JohnPD99/PA_stage_Cubesat/Theory PA Thesis/Preliminary Prototype (fail)/2020_0123_045143_145.JPG

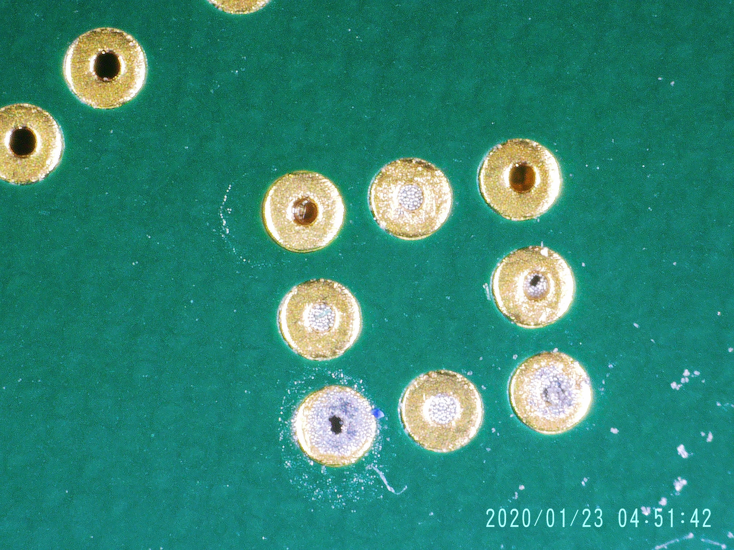
Theory PA Thesis/Preliminary Prototype (fail)/2020_0123_045143_145.JPG
