JohnPD99/PA_stage_Cubesat/Theory PA Thesis/Devboard_TQP9111_Qorvo/TQP9111 PCB2600.jpg

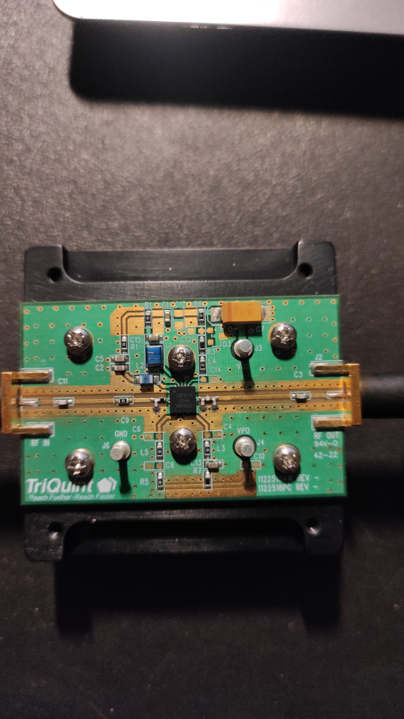
Theory PA Thesis/Devboard_TQP9111_Qorvo/TQP9111 PCB2600.jpg
