JohnPD99/PA_stage_Cubesat/Theory PA Thesis/Update Presentations/Update_W1.pdf

# Design of a PA for a linear transponder on a CubeSat

## Semester thesis

## Linear transponder

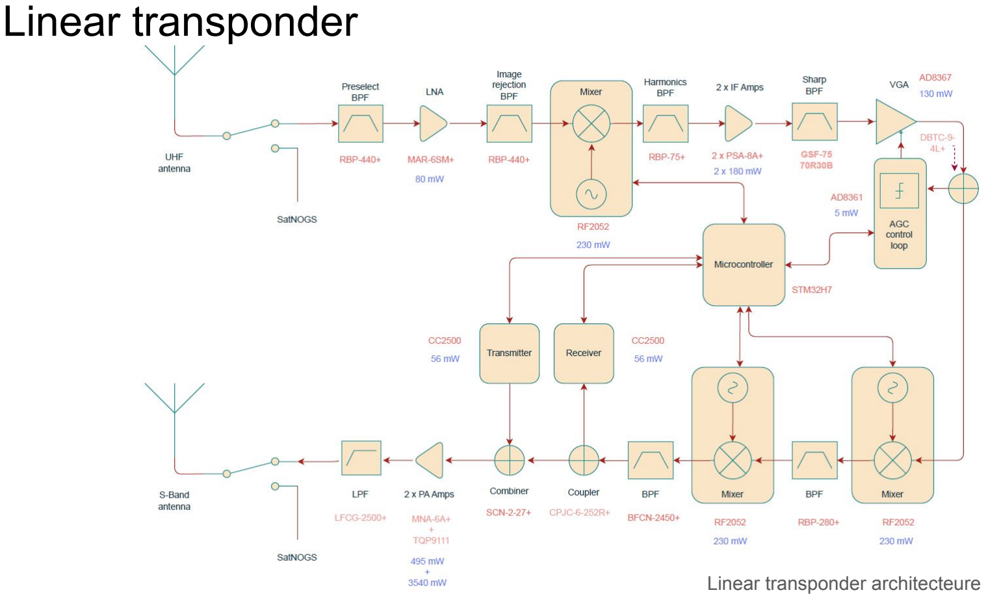
[picture p3: page 2]

Linear transponder architecteure

## Prototype PCB

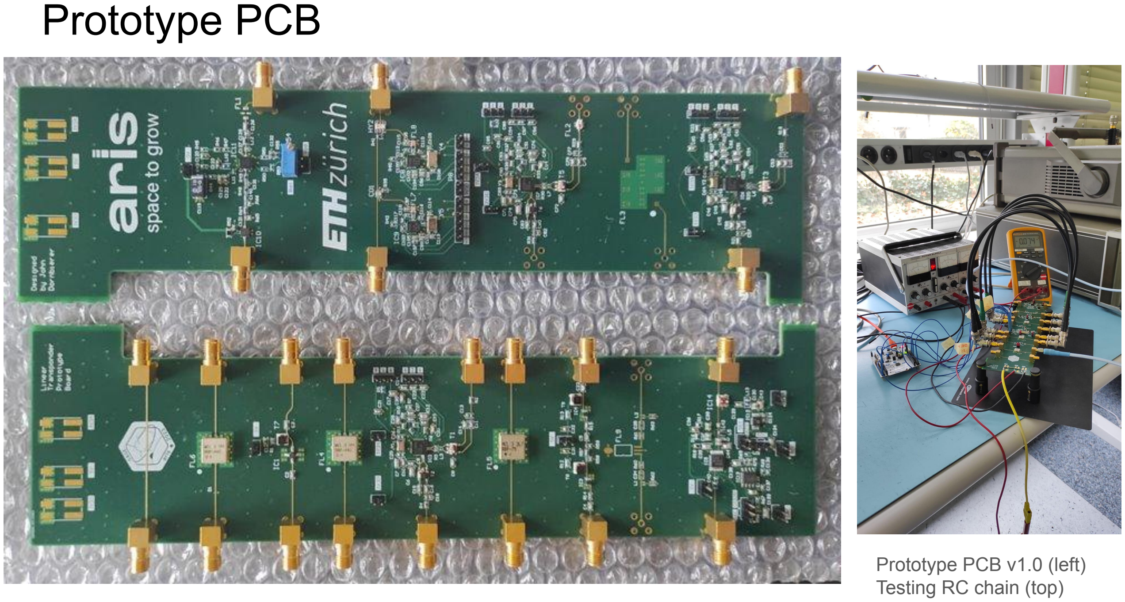
[picture p4: page 3]

Prototype PCB v1.0 (left)
Testing RC chain (top)

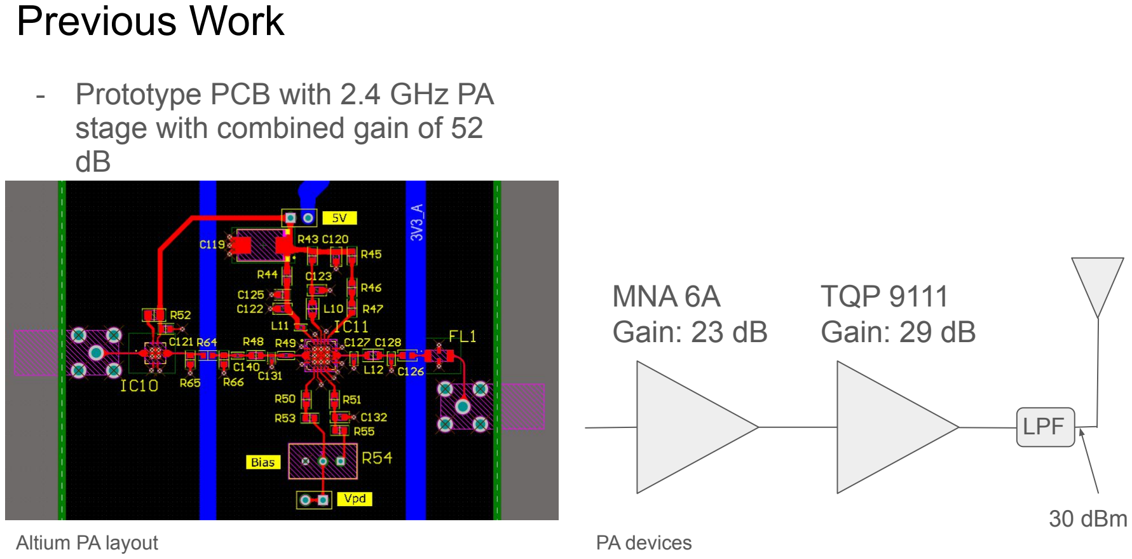
[picture p5: figure]
Previous Work; - Prototype PCB with 2.4 GHz PA stage with combined gain of 52 dB; MNA 6A Gain: 23 dB; TQP 9111 Gain: 29 dB; LPF; 30 dBm; Altium PA layout; PA devices

## Measurements

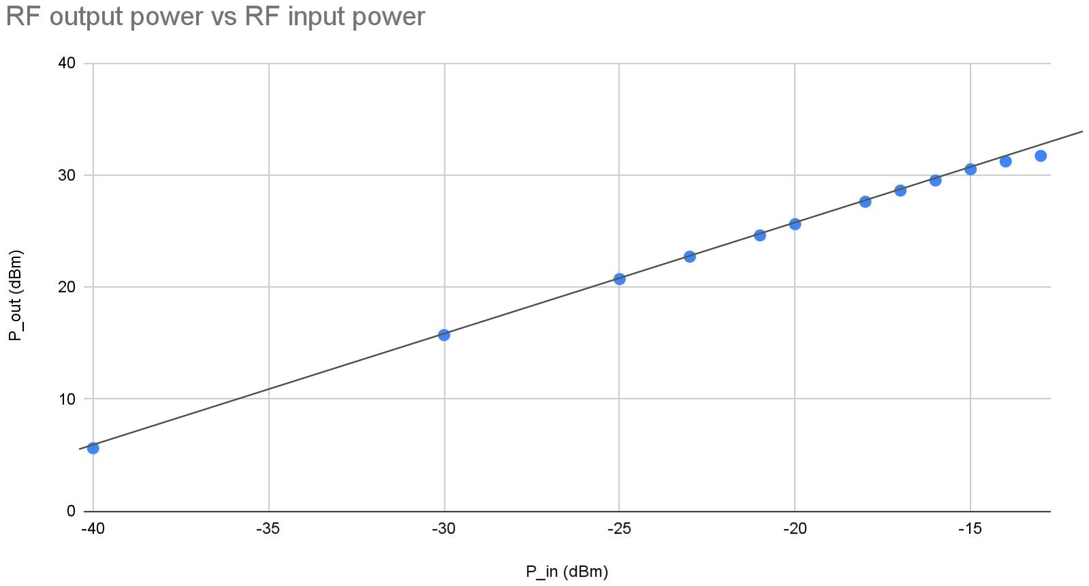
[picture p6: figure]

P1dB:

Measured: 31.7 dBm

datasheet: 32.8 dBm

Gain:

Measured: 45.7 dB

Expected: 52 dB

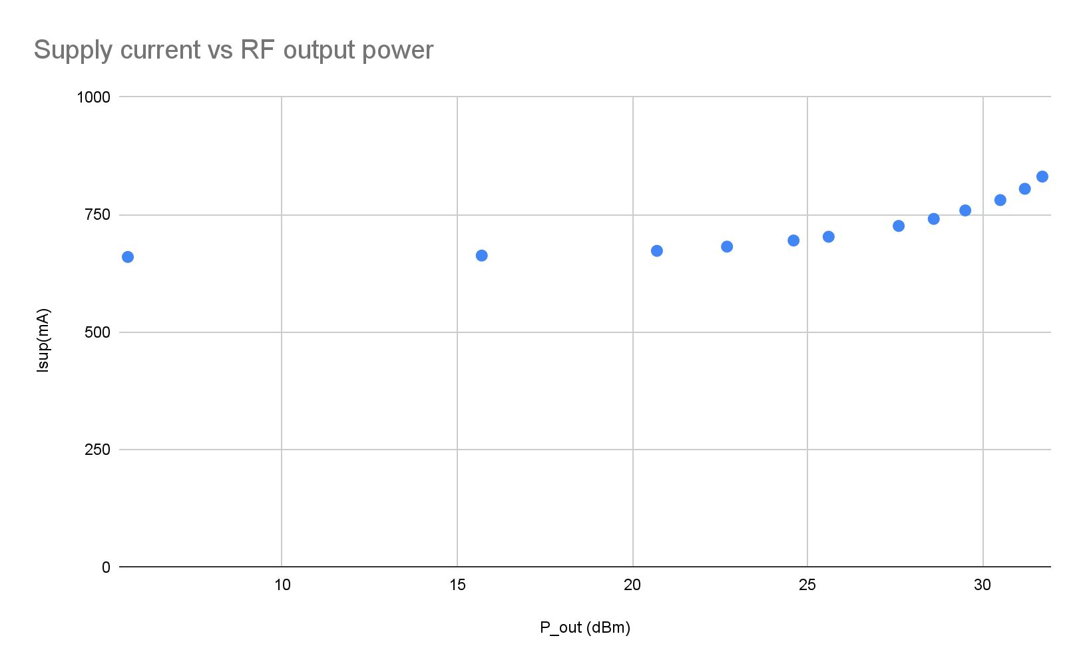
[picture p7: figure]

P_out:

30.5 dBm

Isup:

781 mA (including preamp)

~ 681 mA (without preamp)

Power consumption

~3.4 W

Power dissipation

~2.28 W

## Issues

- Overheating: Prototype wasn’t designed with a heatsink
- TQP9111 reached 150°C at at DC operation
- With small heat sink taped onto vias: 87°C
- → Design an adequate cooling system

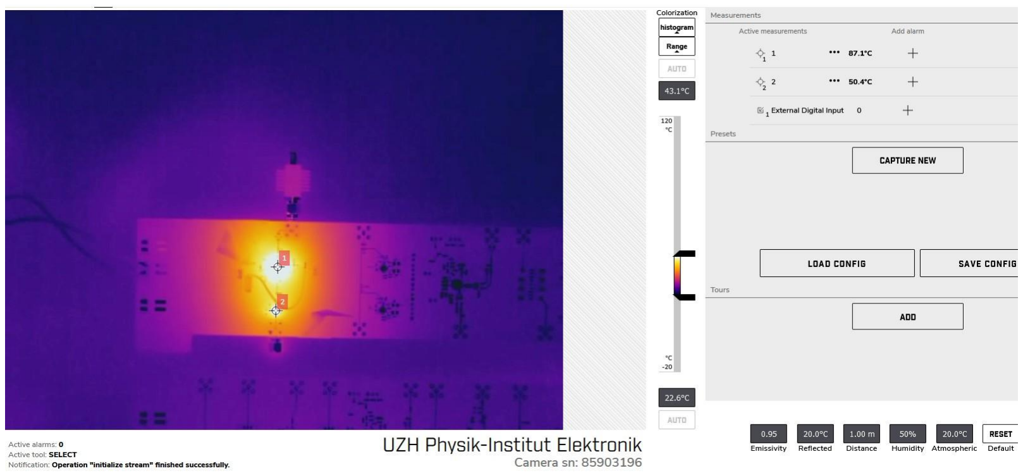
[picture p8: figure]

Thermal image (not in
vacuum, capture after 1 min of DC operation)

Bad impedance matching:

- TL lengths must be adapted (Manufacturer Dev board uses NELCO substrate, we use FR4) → 6.3 dB gain difference compared to expected gain
- → simulate adapted matching in Qucs

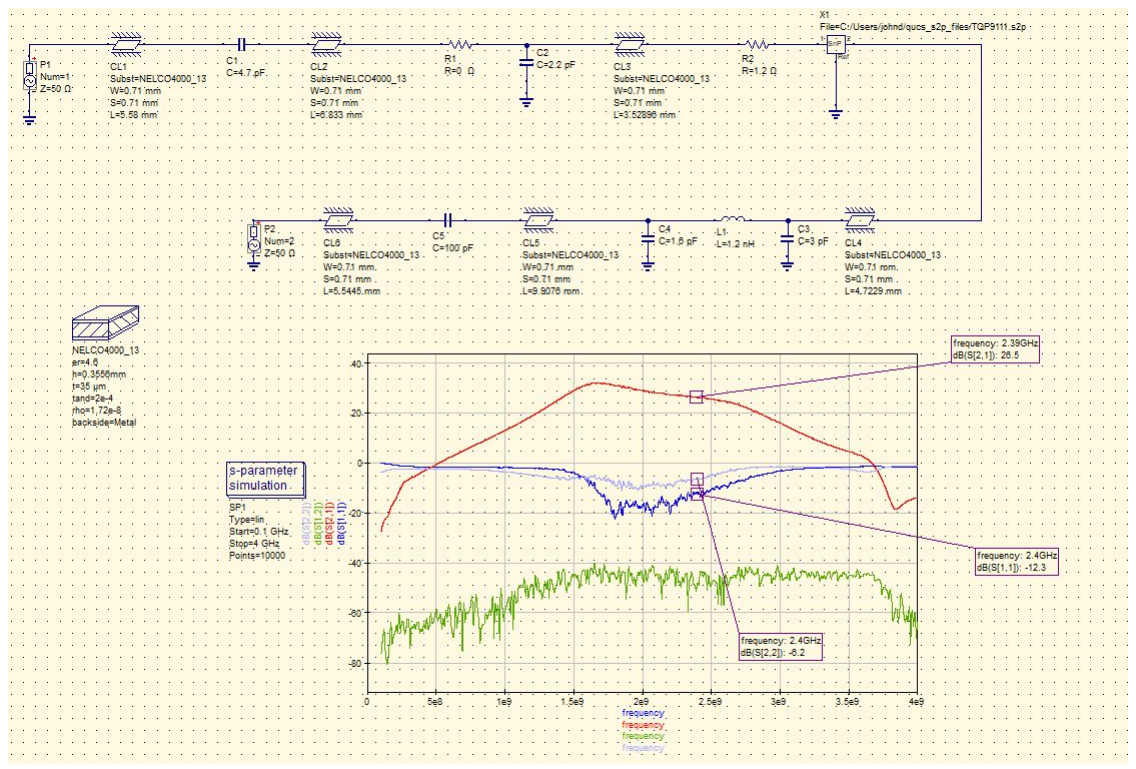
[picture p9: figure]

Qucs simulation of adapted TL lengths for FR4 substrate

## Plan

- Failure Analysis → already done
- Redefine system requirements for PA, since there are no clear defined requirements and check if correct PA choice was made

Gain: 52 dB

P_out: 30 dBm

ACLR, Linearity requirements?

- Redesign a prototype PA PCB
- Implement on Cubesat PCB

## Cubesat PCB

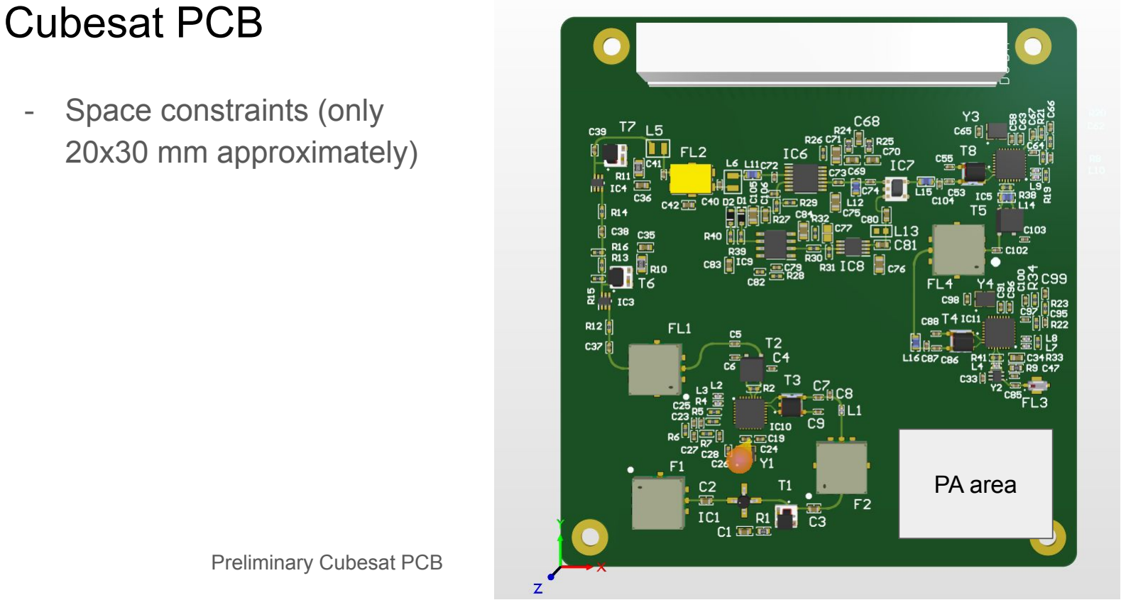
[picture p10: page 10]

- Space constraints (only
20x30 mm approximately)

PA area

Preliminary Cubesat PCB
