JohnPD99/PA_stage_Cubesat/Theory PA Thesis/Update Presentations/Update_W3.pdf

# Amplifier for Linear Transponder: Update W3

## John Dornbierer Semester Thesis

# Reminder

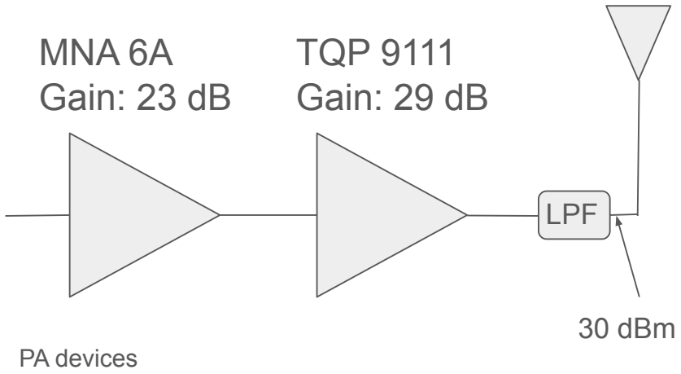
[picture p11: figure]
MNA 6A Gain: 23 dB; TQP 9111 Gain: 29 dB; LPF; 30 dBm; PA devices

## Updates

- Ordered Devboard of TQP9111 (main amplifier). It uses an expensive RF substrate (NELCO 4000). Idea: Use it as a reference to measure performance degradation on FR4 7628 substrate (used for linear transponder in Cubesat)

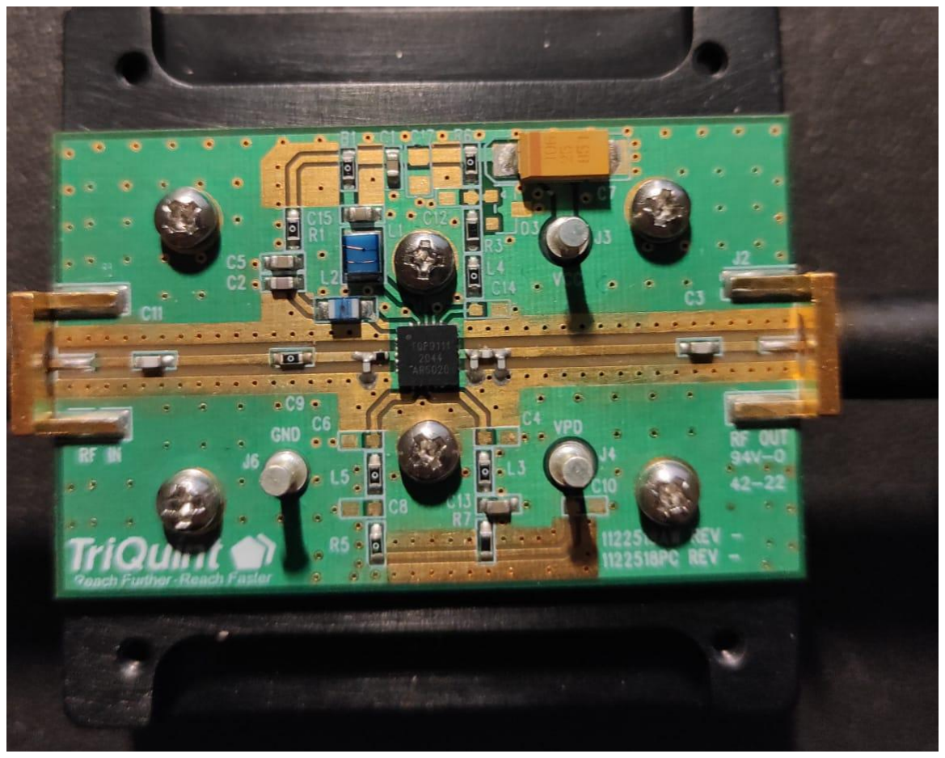
[picture p12: figure]

Qorvo PCB2600 Dev Board

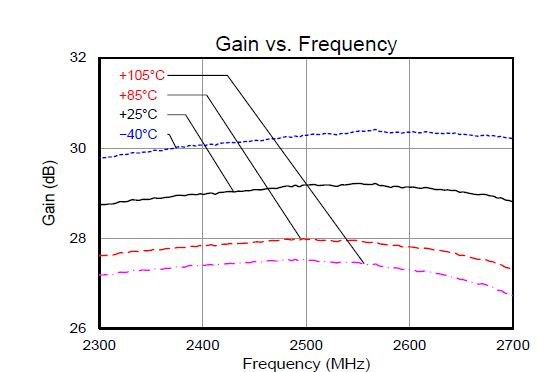
[picture p13: figure]

Qorvo PCB2600 Datasheet advertised gain

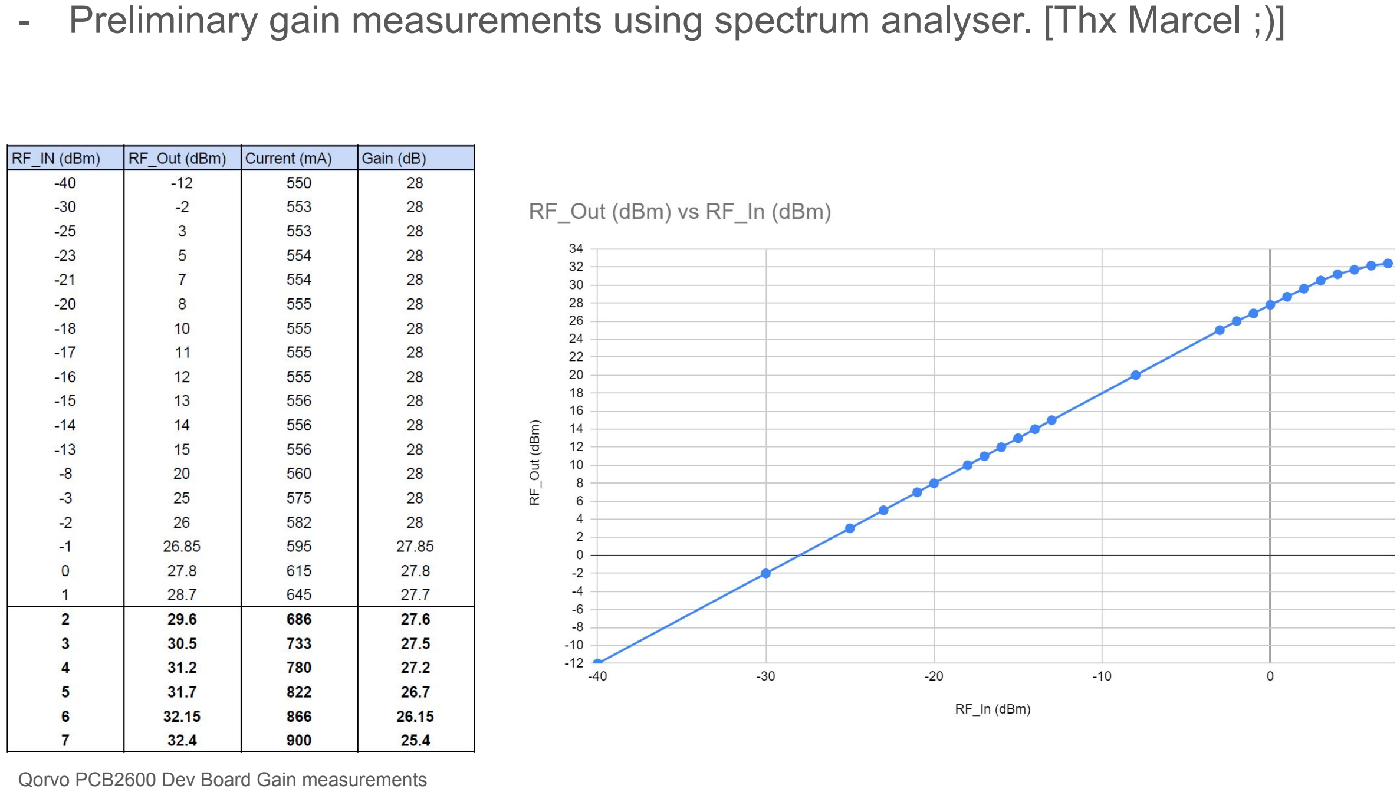
[picture p14: page 4]

- Preliminary gain measurements using spectrum analyser. [Thx Marcel ;)]

Qorvo PCB2600 Dev Board Gain measurements

Results compared to datasheet:

- Gain at low RF input power:

DevBoard: 28 dB (VCC 5V 550 mA, ~25 °C)

Datasheet: 29 dB (VCC 5V 545 mA, 25°C)

- Gain at 30.5 dBm RF output power

DevBoard: 27.5 dB (VCC 5V 733 mA, ~25°C)

- OP1dB

DevBoard: ~31.2 dBm at ~25 °C

Datasheet: 33 dBm at 25 °C

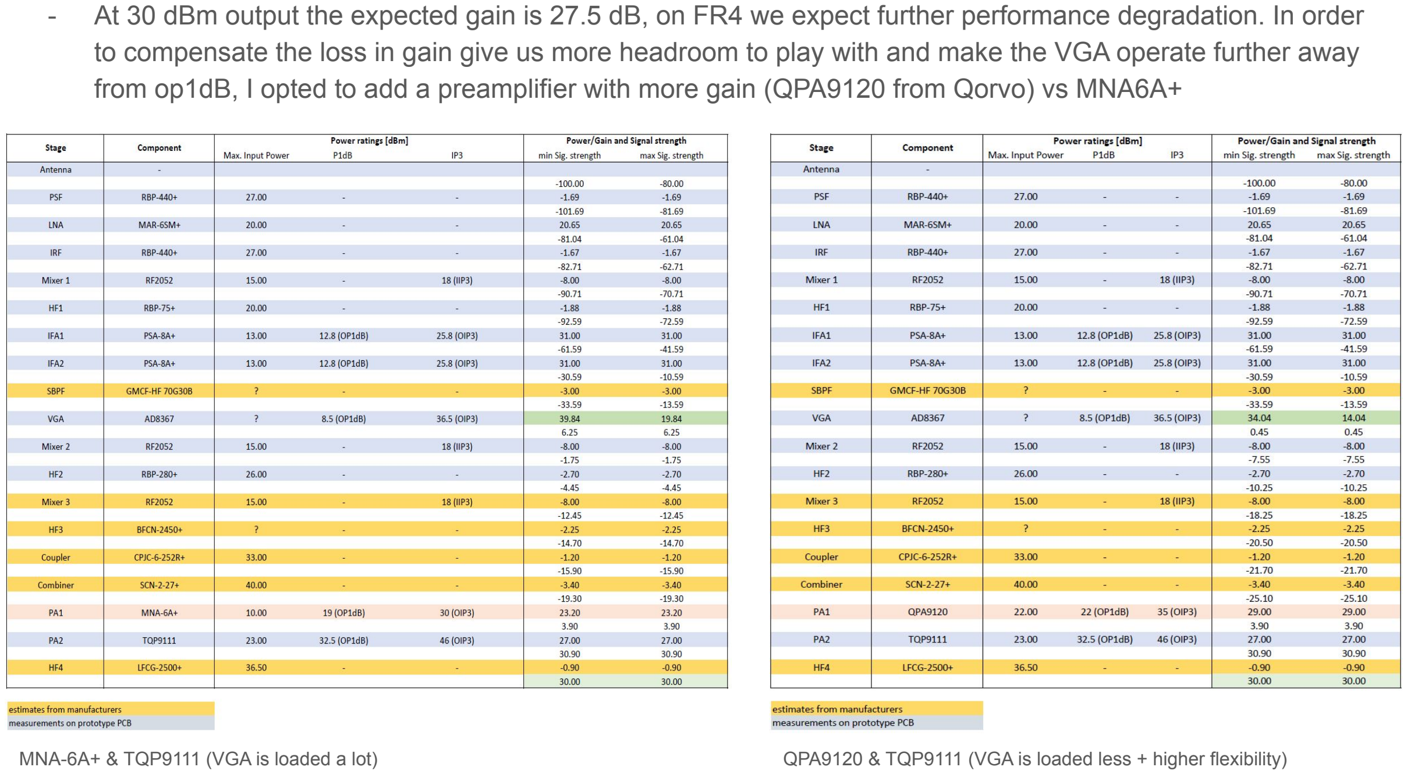
[picture p15: page 6]

- At 30 dBm output the expected gain is 27.5 dB, on FR4 we expect further performance degradation. In order to compensate the loss in gain give us more headroom to play with and make the VGA operate further away from op1dB, I opted to add a preamplifier with more gain (QPA9120 from Qorvo) vs MNA6A+
MNA-6A+ & TQP9111 (VGA is loaded a lot) | QPA9120 & TQP9111 (VGA is loaded less + higher flexibility)

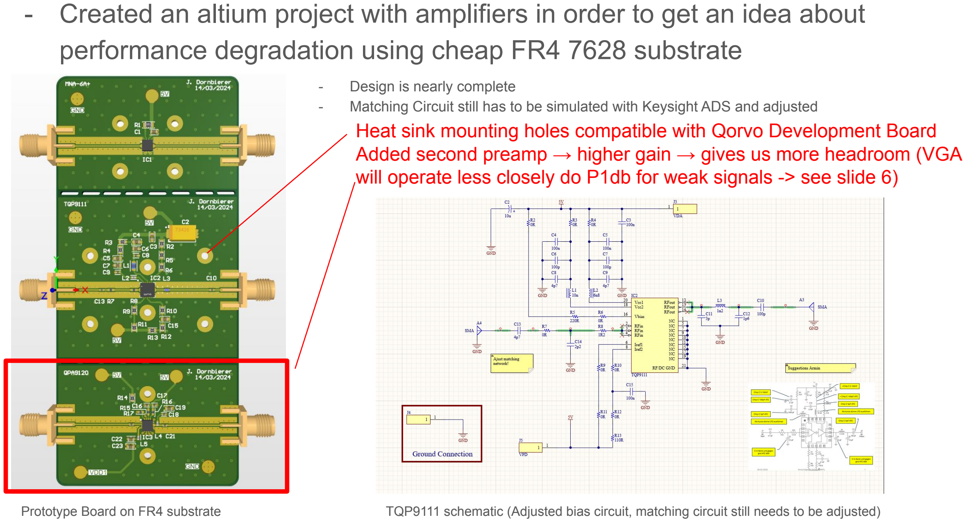
[picture p16: page 7]

- Created an altium project with amplifiers in order to get an idea about performance degradation using cheap FR4 7628 substrate
- Design is nearly complete
- Matching Circuit still has to be simulated with Keysight ADS and adjusted
Prototype Board on FR4 substrate | TQP9111 schematic (Adjusted bias circuit, matching circuit still needs to be adjusted)

Heat sink mounting holes compatible with Qorvo Development Board Added second preamp → higher gain → gives us more headroom (VGA will operate less closely do P1db for weak signals -> see slide 6)

## Impedance matching circuit

In order to gain more insights into the matching I tried to calculate the optimum source and load impedances for the TQP9111. I used de-embedded S-parameters for this.

2.4 GHz, 5V, 545 mA at 25°C

S11 = 0.802654 / 162.7281°

S21 = 9.90529 / 79.60395 °

S12 = 0.0019171 / 96.81241 °

S22 = 0.818418 / -178.5883 °

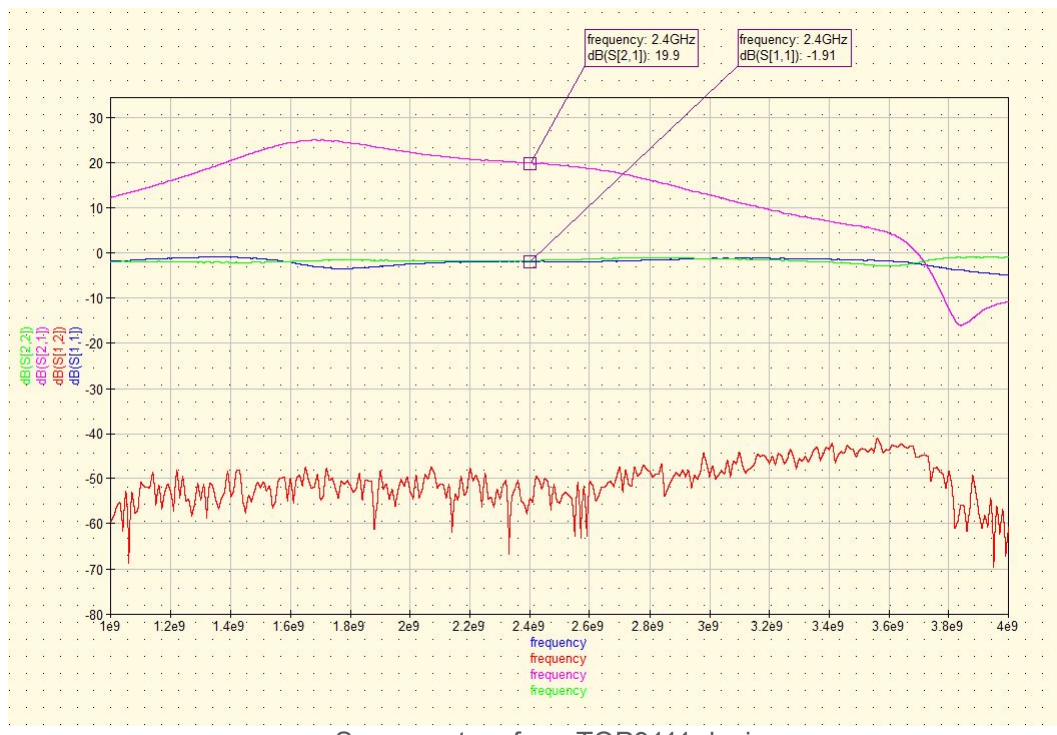
[picture p17: figure]

S-parameters from TQP9111 device

Stability:

Ds = S11 * S22 - S12 * S21 = 0.675474 / -15.5177°

K = (1 + |Ds|² - |S11|² - |S22|²) / (2*|S12|*|S21|) = 3.74425 > 1

→ unconditionally stable

Maximum achievable gain:

B1 = 1 + |S11|² - |Ds|² - |S22|² = 0.51818 > 0

MAG = 10 log(|S21| / |S12|) + 10 log(K - √K² - 1 ) = 28,4678 dB

→ According to datasheet 29 dB is possible

Optimal load impedance calculation:

C2 = S22 - Ds*conj(S11) = 0.276275 / -179.26 °

B2 = 1 + |S22|² - |Ds|² - |S11|² = 0.56929 > 0

|ΓL | = (B2 - √B2² - 4*|C2|² ) / 2*|C2| = 0.782286, ang(ΓL) = 179.26 °

→ ZL = 50 * (1+ ΓL) / (1- ΓL) = 6.10798 + 0.317883*j

Optimal source impedance calculation:

ΓS = S11 + (S12 * S21 * ΓL) / (1 + S22 * ΓL)

→ ZS = 50 * (1+ Γs) / (1- Γs) = 6.89762 - 7.78518*j

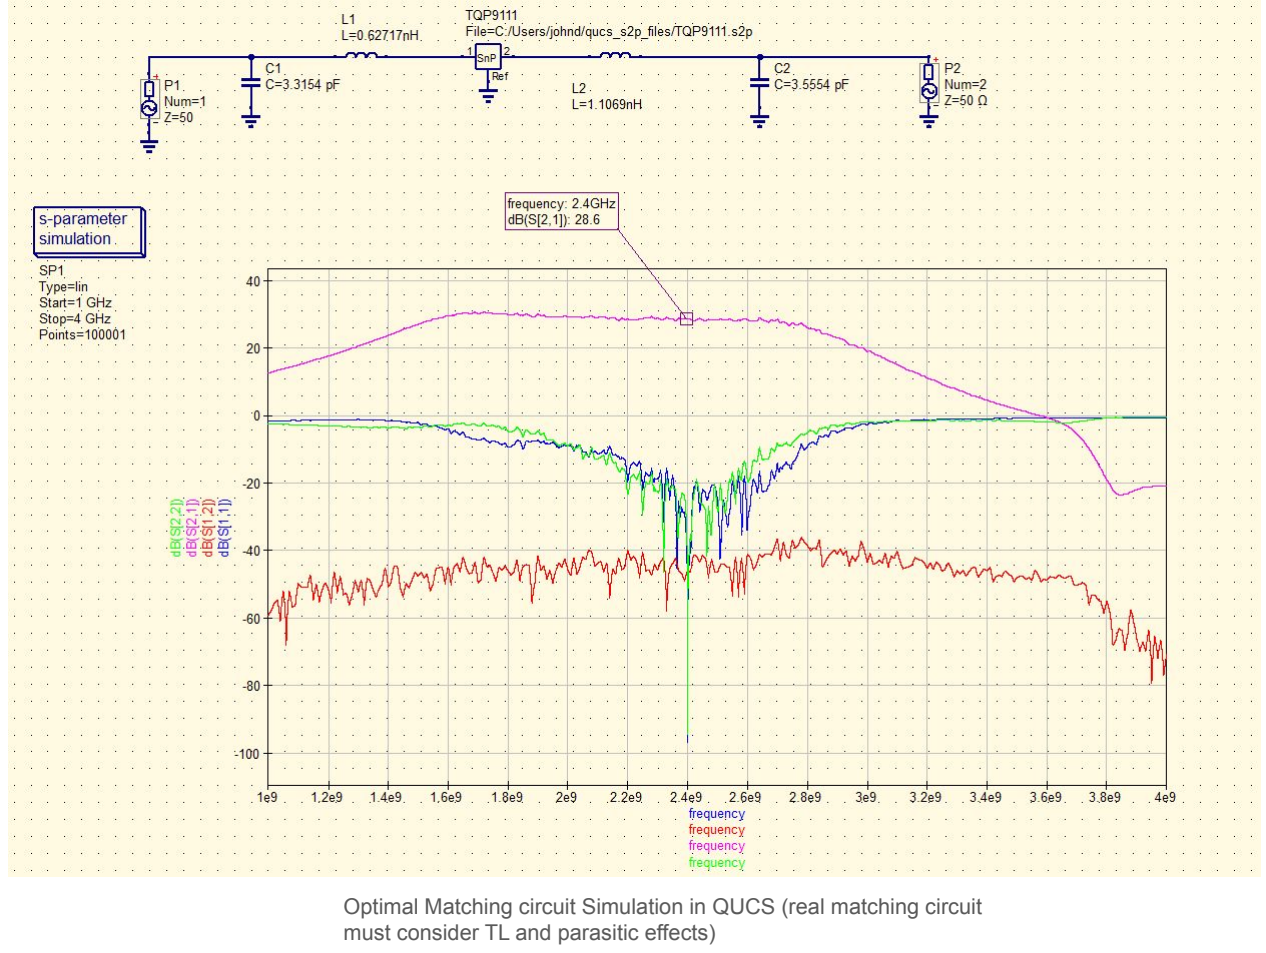
[picture p18: page 11]

Optimal Matching circuit Simulation in QUCS (real matching circuit must consider TL and parasitic effects)

## Reverse Engineering of Matching Circuit in datasheet

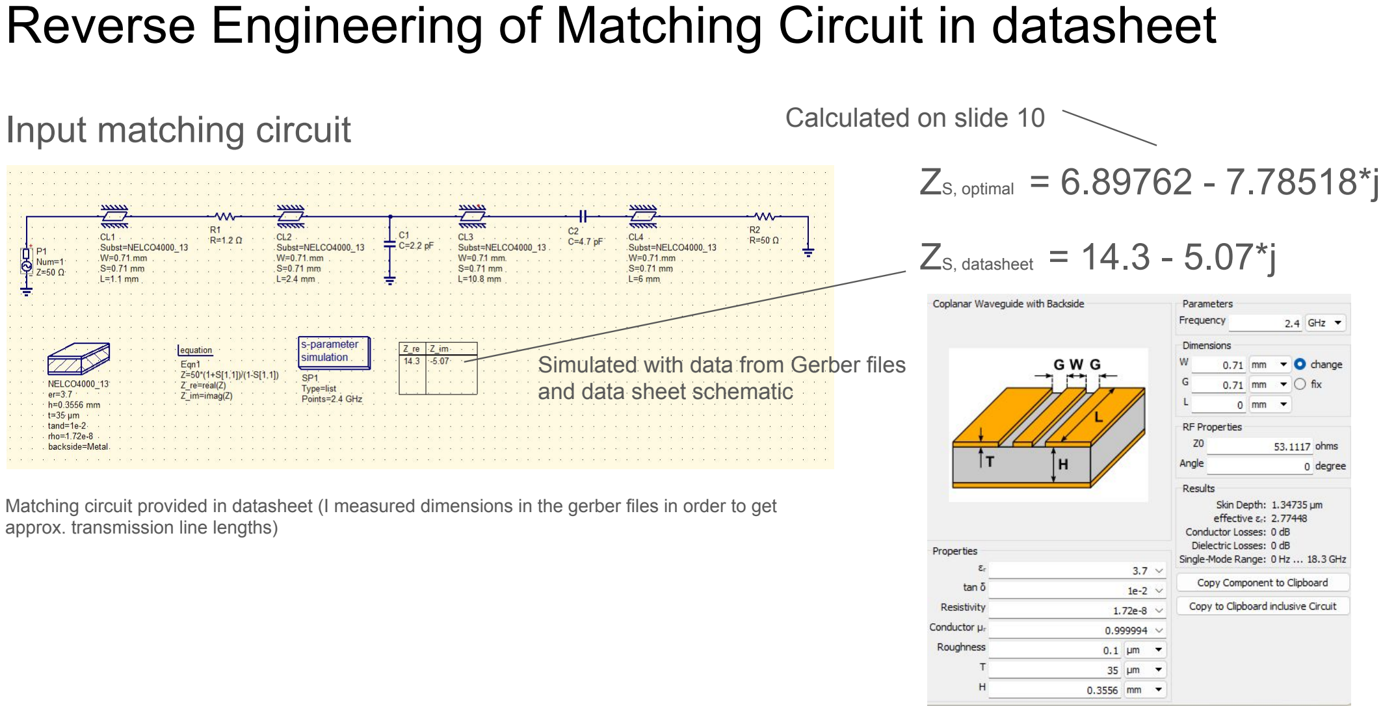
[picture p19: page 12]

Input matching circuit

Matching circuit provided in datasheet (I measured dimensions in the gerber files in order to get approx. transmission line lengths)

ZS, optimal = 6.89762 - 7.78518*j

ZS, datasheet = 14.3 - 5.07*j

Calculated on slide 10

Simulated with data from Gerber files and data sheet schematic

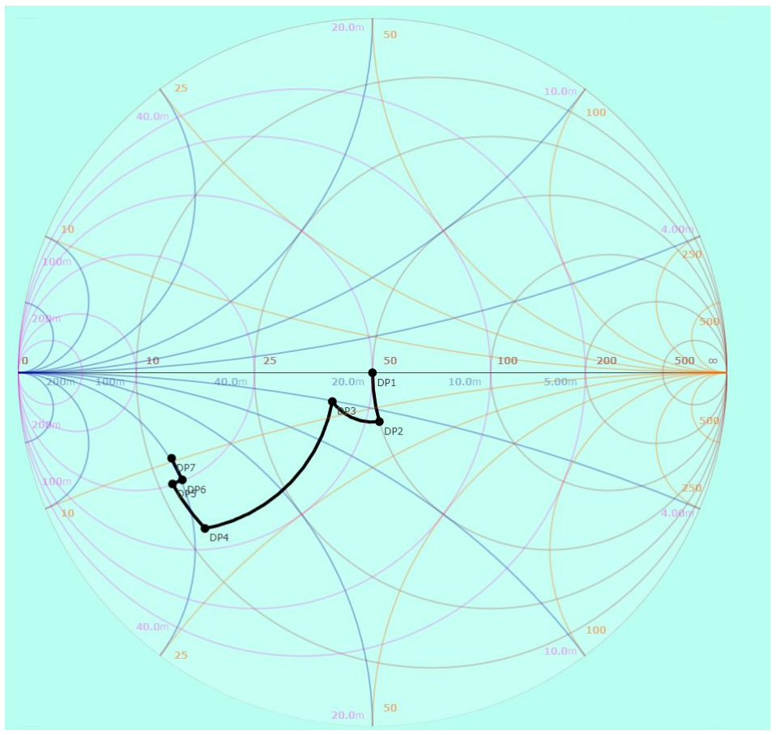
[picture p20: figure]

Smith Chart

Output matching circuit

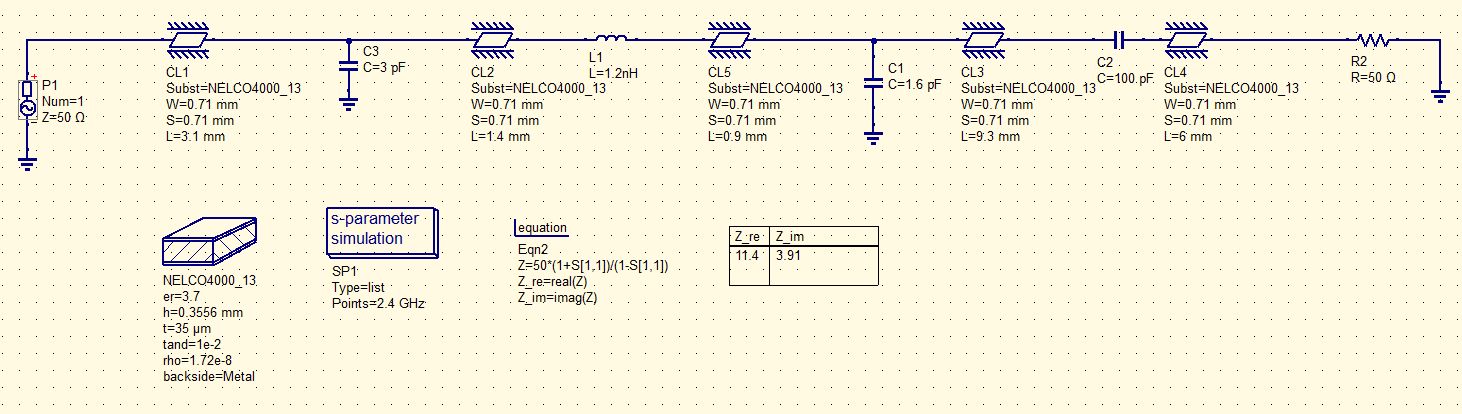
[picture p21: figure]

Matching circuit provided in datasheet (I measured dimensions in the gerber files in order to get approx. transmission line lengths)
ZL, opt = 6.10798 + 0.317883*j

ZL, datasheet = 11.4 + 3.91*j

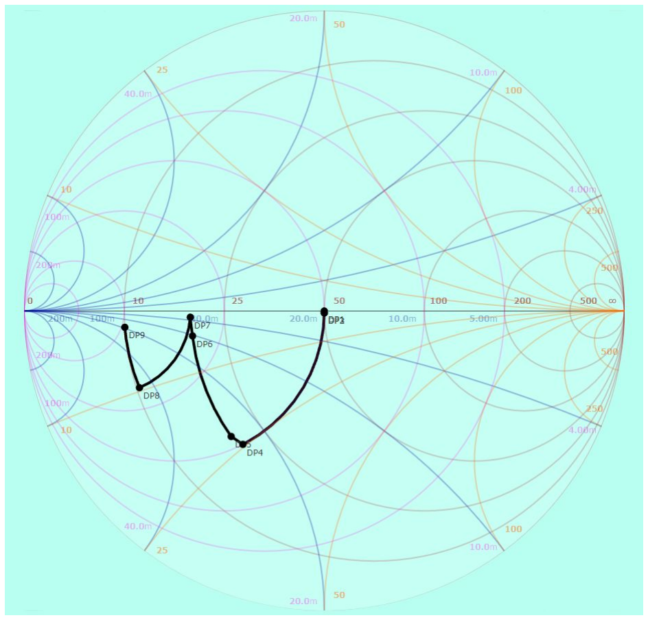
[picture p22: figure]

Smith Chart

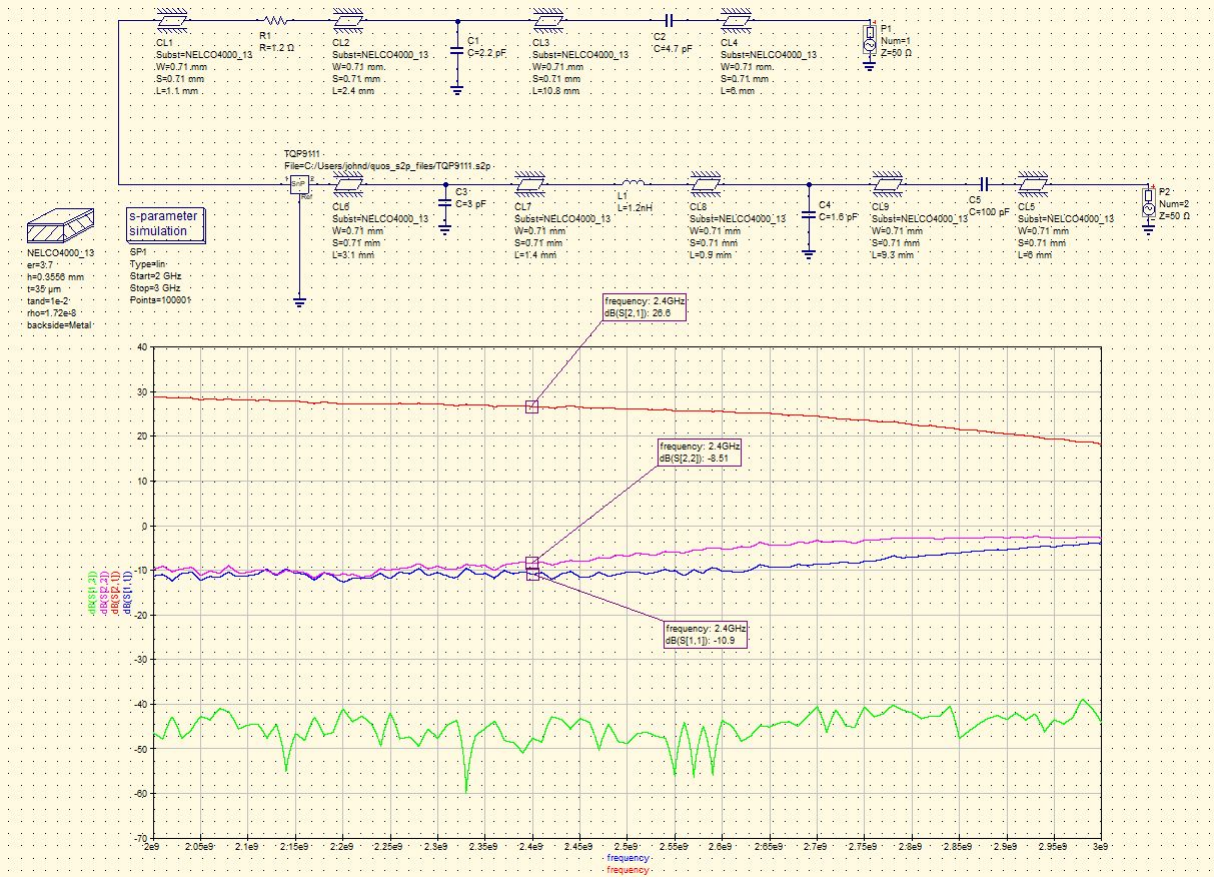
[picture p23: figure]

Simulation of datasheet matching circuit

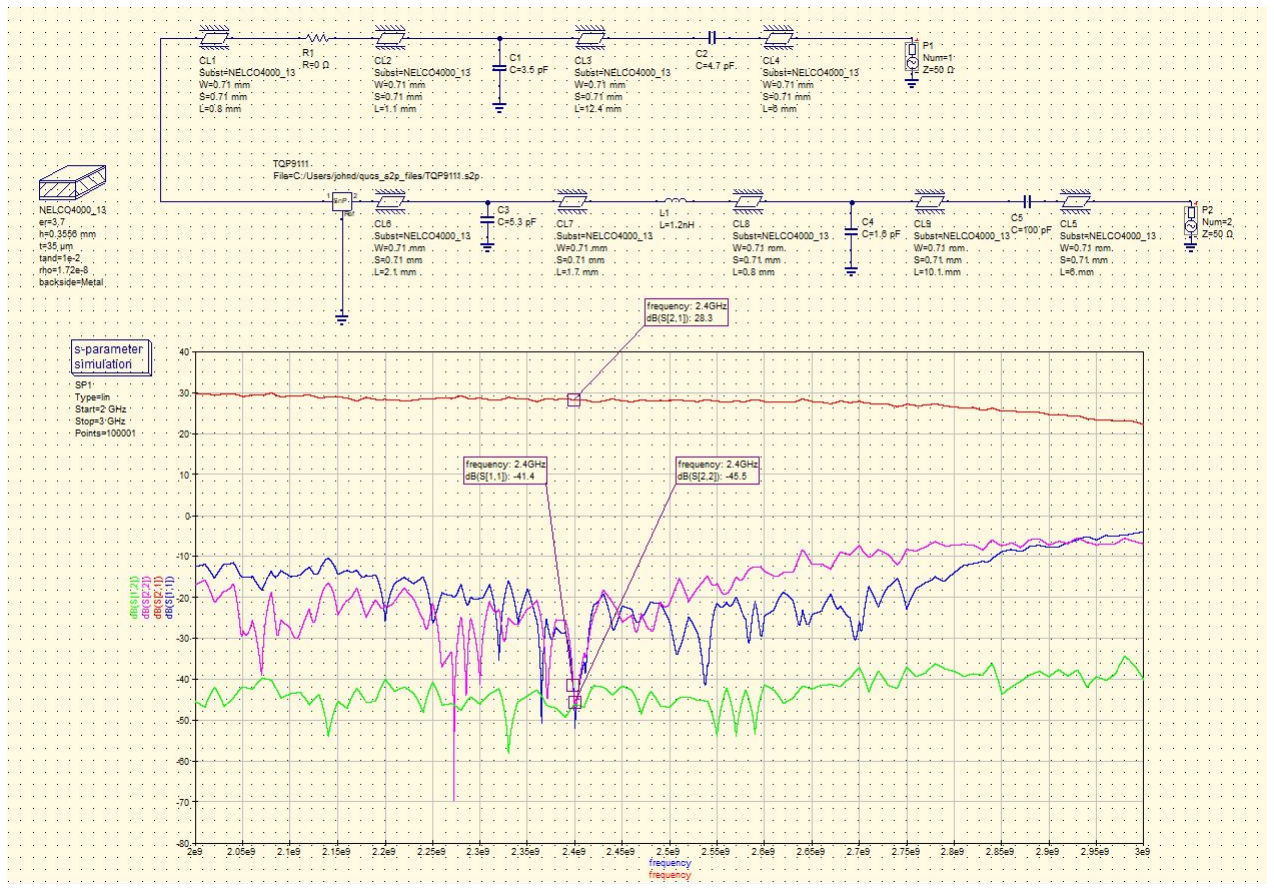
[picture p24: figure]

Simulation of modified and optimised datasheet circuit

## Matching Circuit on DevBoard

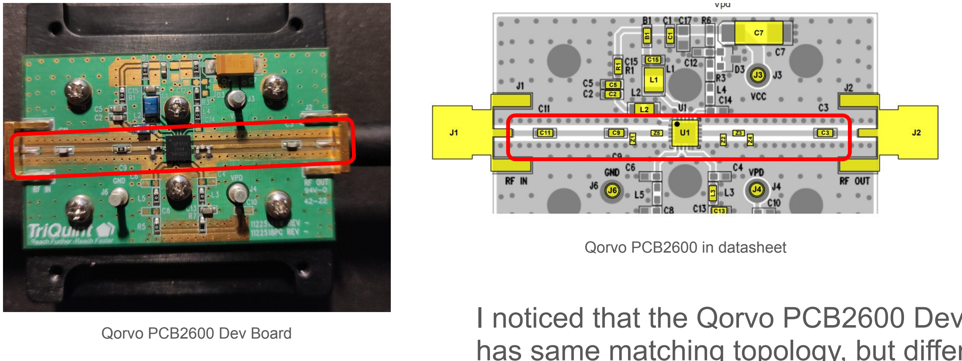
[picture p25: figure]
Qorvo PCB2600 Dev Board; Qorvo PCB2600 in datasheet

I noticed that the Qorvo PCB2600 Dev Board has same matching topology, but different layout and maybe different components, since simulating the matching of the Dev Board gives bad results. I wrote an E-Mail to Qorvo about this.

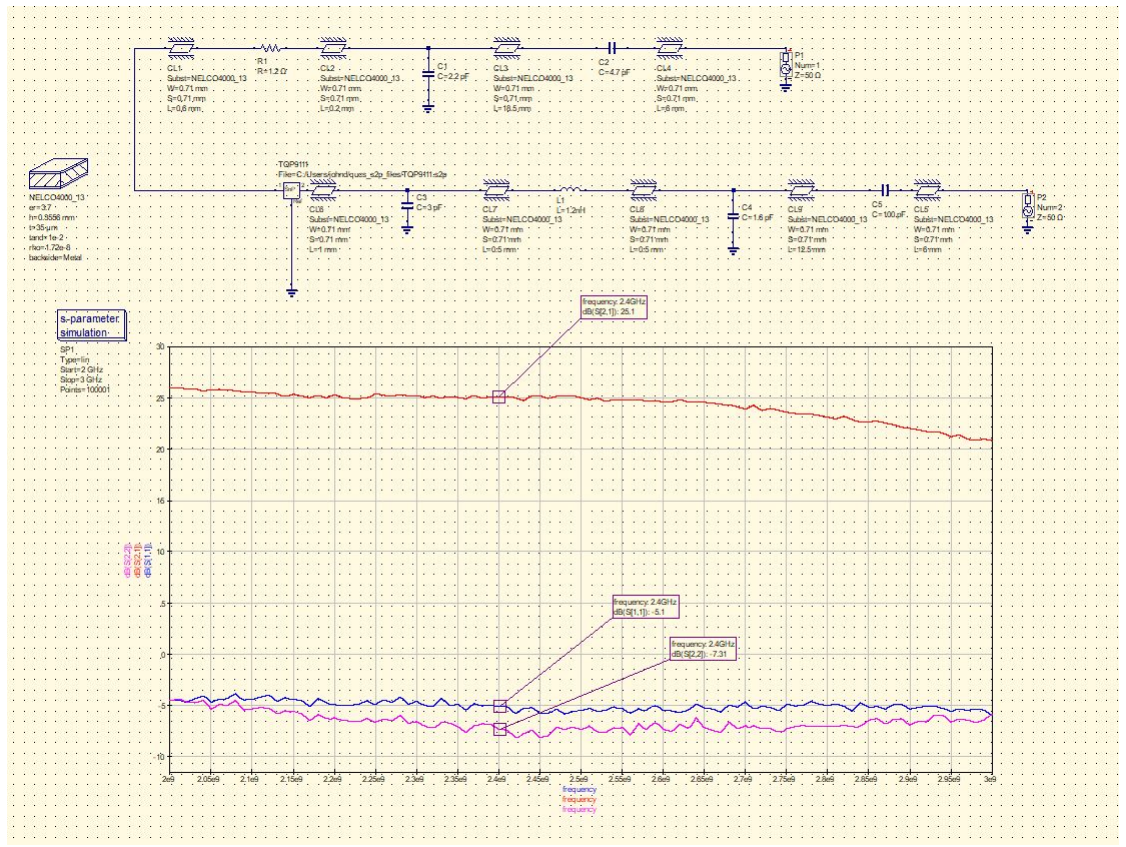
[picture p26: figure]

Simulation of PCB2600 matching circuit → bad results

## Update: Yes indeed Quorvo responded with a new matching

Some components changed. When I resimulate I get better results!

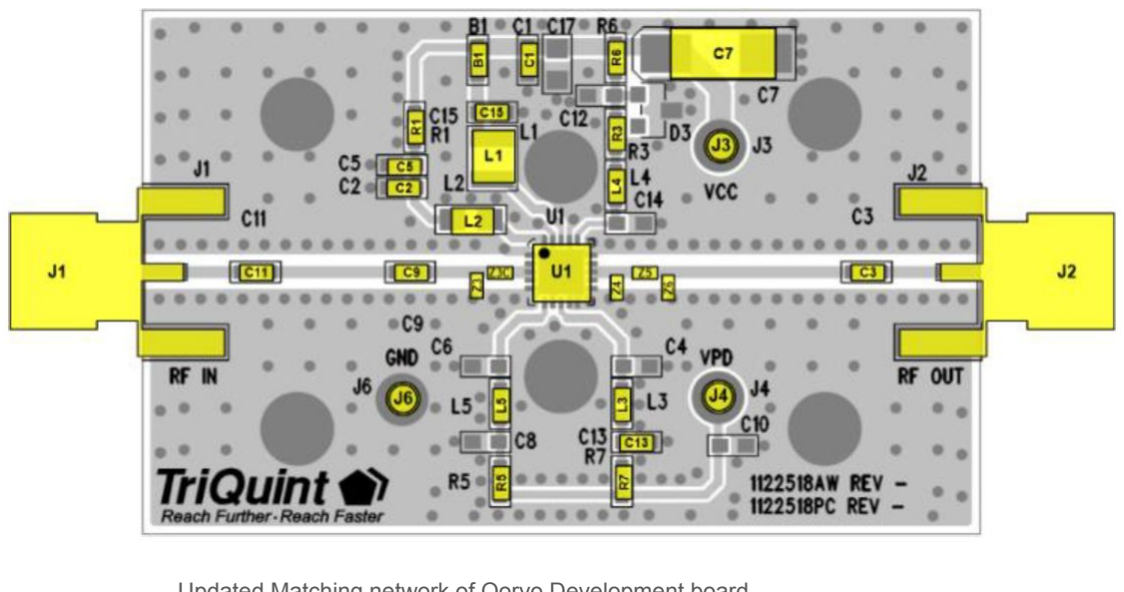
[picture p27: figure]

Updated Matching network of Qorvo Development board

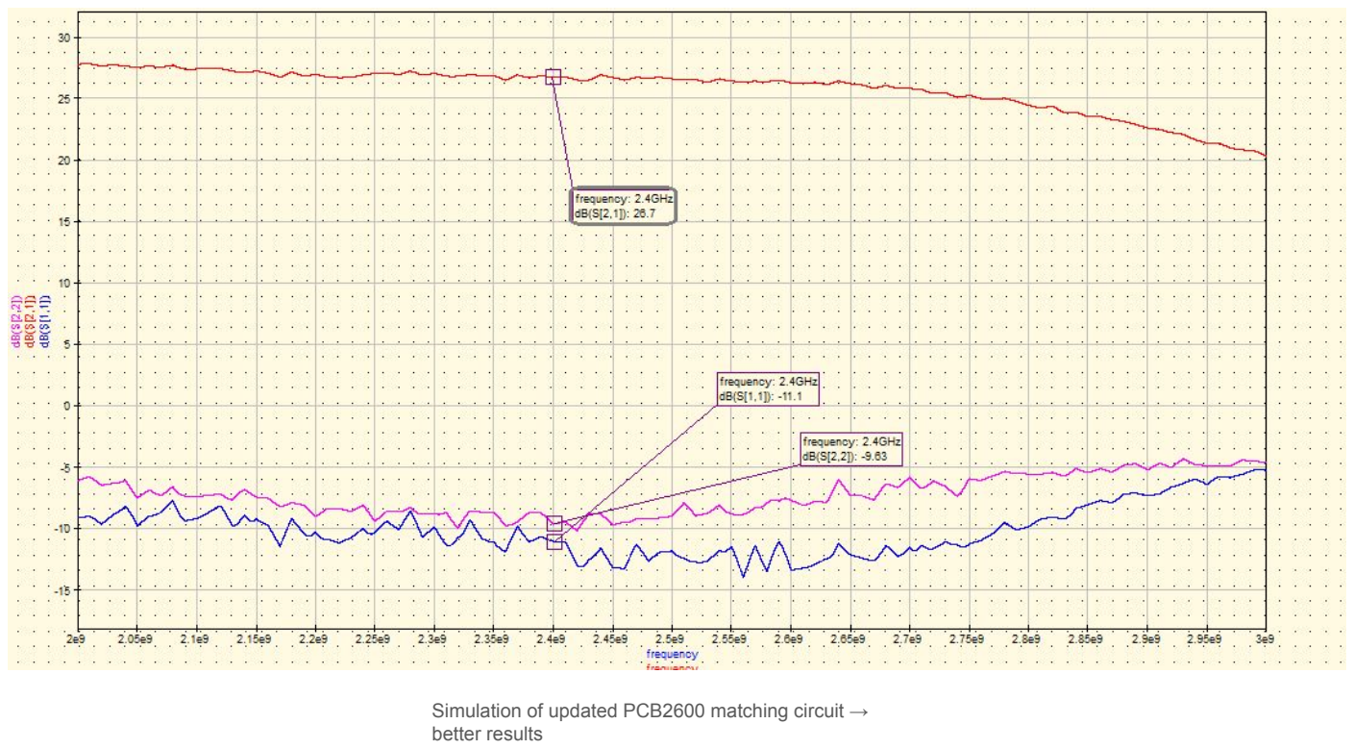
[picture p28: page 21]

Simulation of updated PCB2600 matching circuit → better results

What is the loss tangent and electric constant at 2.4 GHz for FR4 7628 from JLCPCB? → No data for 2.4 GHz

Solution: I wrote an E-Mail to JLCPCB, if they could provide information about those values, they said they will check with the manufacturing fab.

For now I just took standard values for FR4 7628 @ 2.4 GHz:

Df = 0.02

E_r = 4.4

I believe that this will not really have a great influence on the final matching, if the numbers in reality are slightly different. This can also be checked while simulating with Keysight ADS!

## Matching on FR4 board

Matching on FR4 board | Coplanar waveguide
| | calculator
Input matching circuit

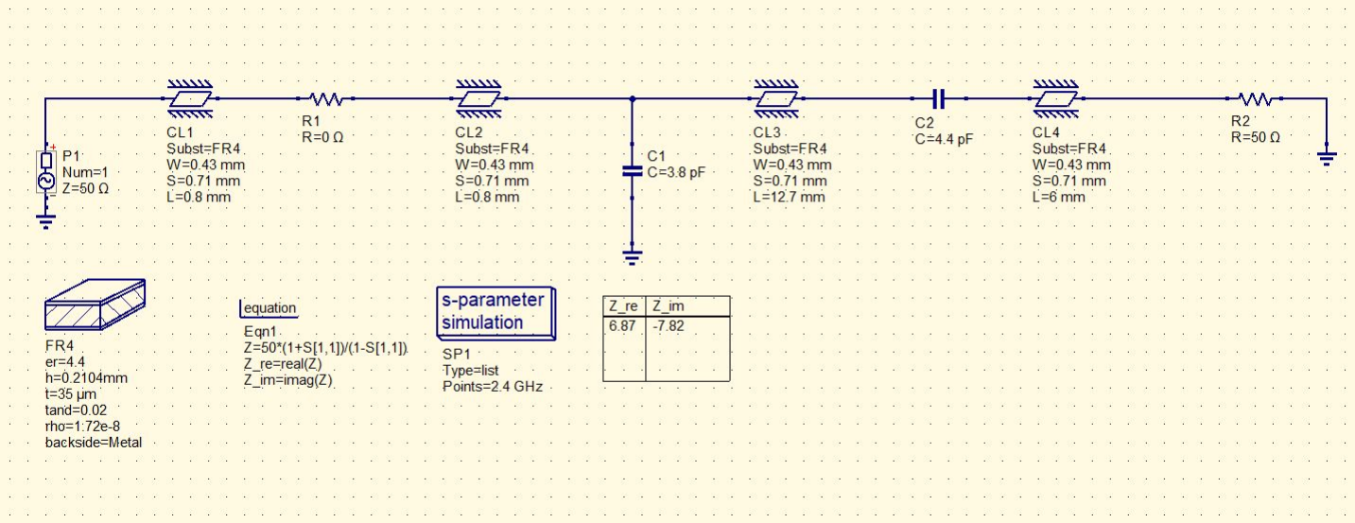
[picture p29: figure]

Optimised circuit on FR4 7628 substrate

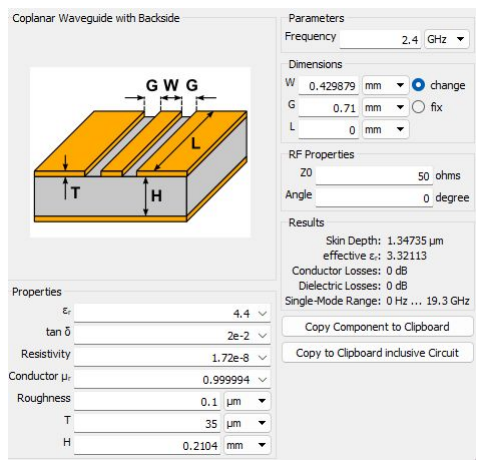
[picture p30: figure]

ZS, opt = 6.89762 - 7.78518*j

ZS, FR4 = 6.87000 - 7.82000*j

Output matching circuit

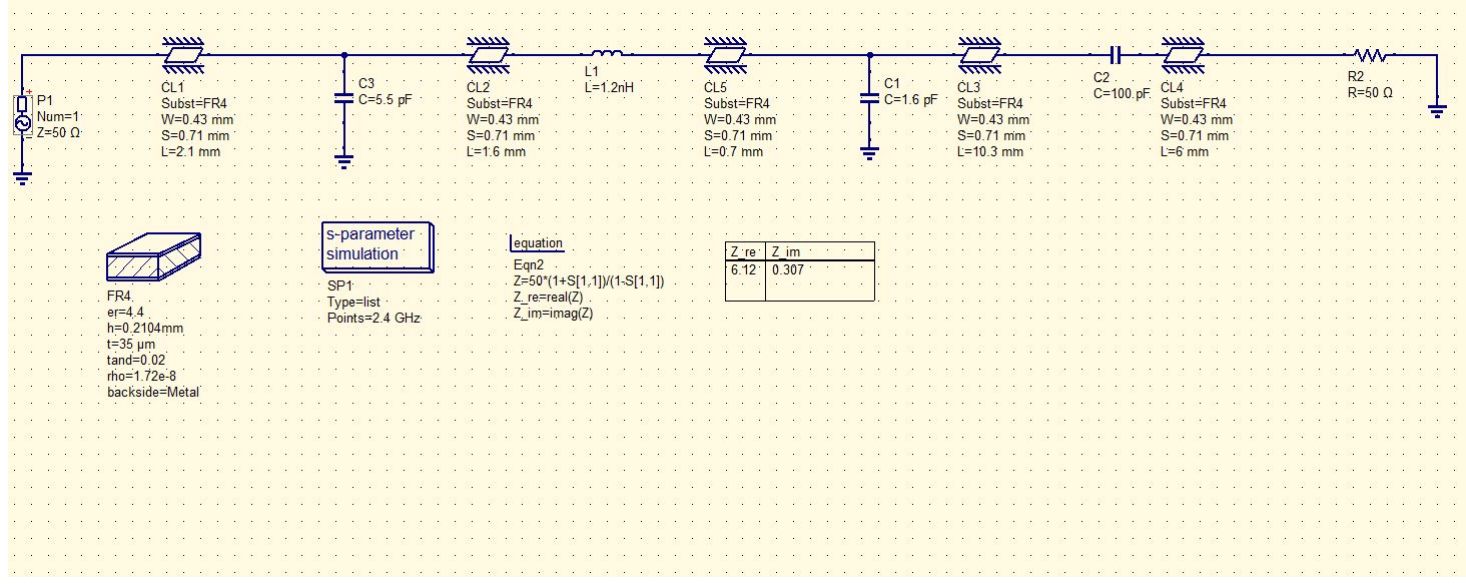
[picture p31: figure]

Optimised circuit on FR4 7628 substrate

ZL, opt = 6.10798 + 0.317883*j

ZL, FR4 = 6.1200 + 0.307*j

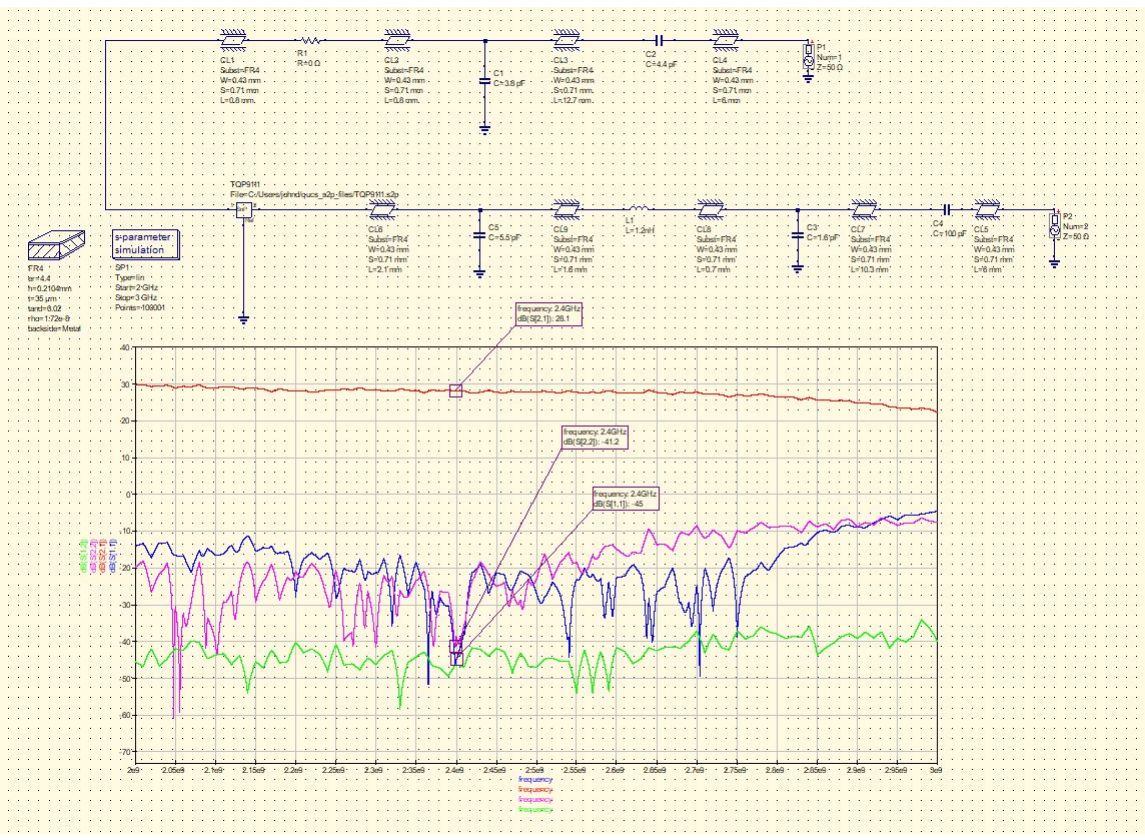
[picture p32: figure]

Complete optimised circuit on FR4 7628 substrate

## Conclusions

1) Preliminary calculations and simulations with QUCS make sense
2) With Qucs the SMD pads and many other effects cannot be simulated accurately, which is the reason the simulated impedance of the matching circuit is a bit different from the optimally calculated values
3) In order to get more accurate results, I need to simulate with Keysight ADS

## Next steps

- Wait for response from Qorvo and potentially adjust simulated matching circuits in QUCS to new one from Qorvo
- Measure S-parameters of PCB2600 board and compare with simulations
- Get Keysight license and design optimal matching for FR4 7628 substrate
- Adjust matching circuit on prototype board in Altium and send of for manufacturing
- Perform measurements on FR4 board
- Design PA for final board on Cubesat
