JohnPD99/PA_stage_Cubesat/Theory PA Thesis/Devboard_TQP9111_Qorvo/Messwerte.png

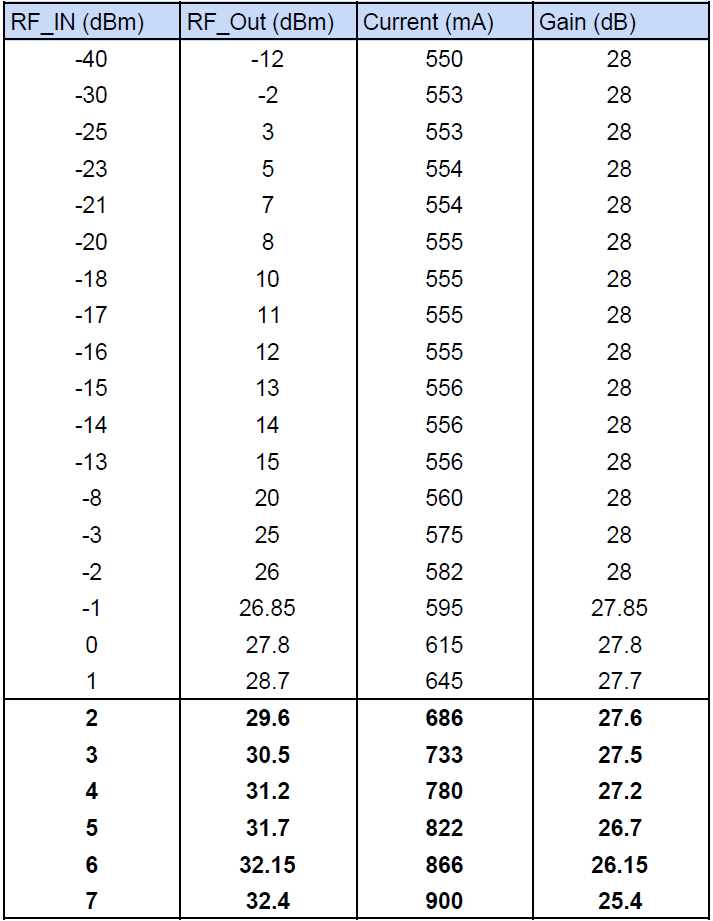
Theory PA Thesis/Devboard_TQP9111_Qorvo/Messwerte.png
