JohnPD99/PA_stage_Cubesat/Theory PA Thesis/Devboard_TQP9111_Qorvo/TQP9111 PCB2600 datasheet layout.png

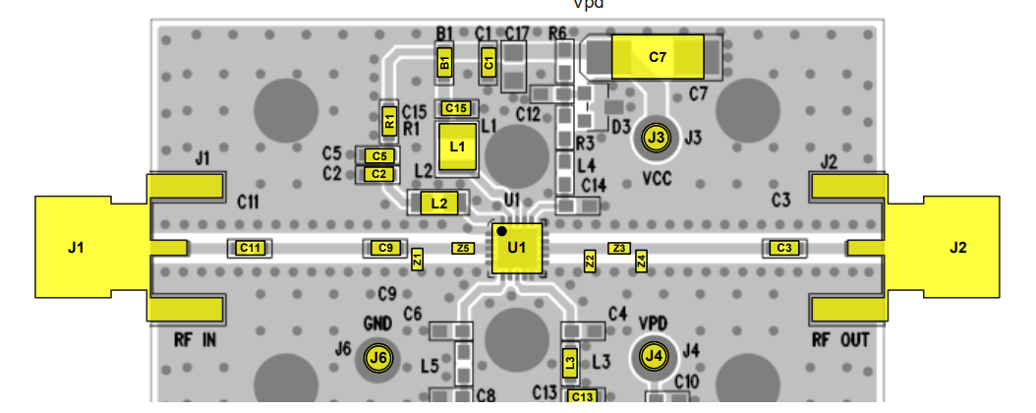
Theory PA Thesis/Devboard_TQP9111_Qorvo/TQP9111 PCB2600 datasheet layout.png
