JohnPD99/PA_stage_Cubesat/Theory PA Thesis/Funkamateur Besprechungen/PA_ARMIN_ACHIM/PA Messung_TQP9111_MNA6A_Achim_John.png

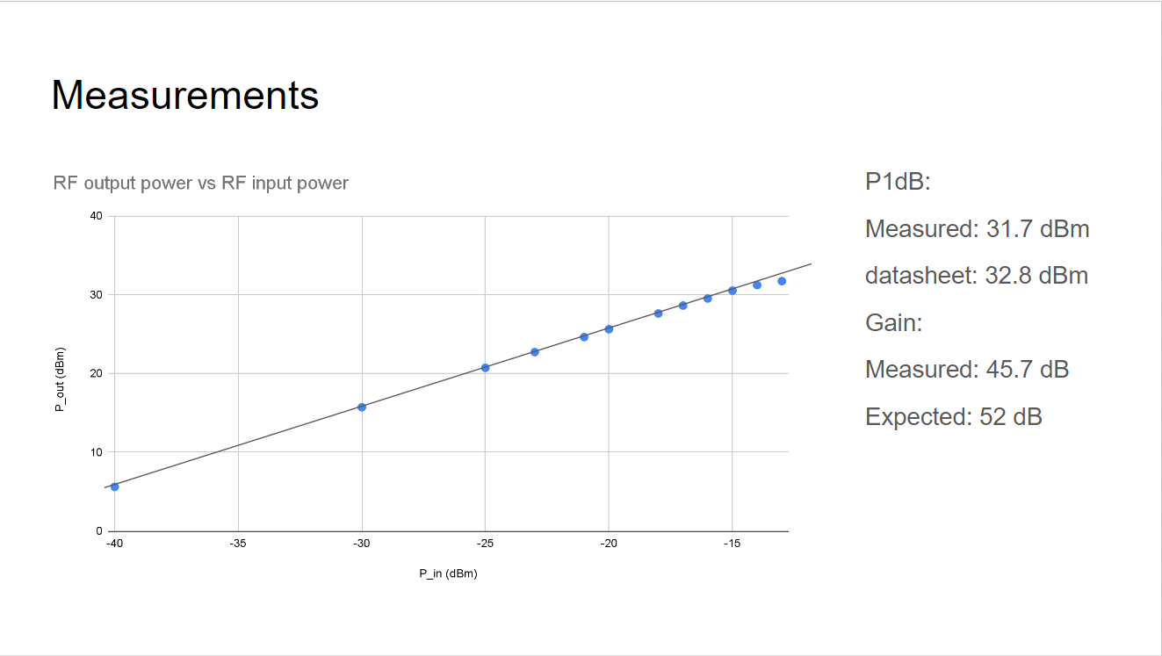
Theory PA Thesis/Funkamateur Besprechungen/PA_ARMIN_ACHIM/PA Messung_TQP9111_MNA6A_Achim_John.png
