JohnPD99/PA_stage_Cubesat/Theory PA Thesis/Funkamateur Besprechungen/PA_ARMIN_ACHIM/PCB_Layout.png

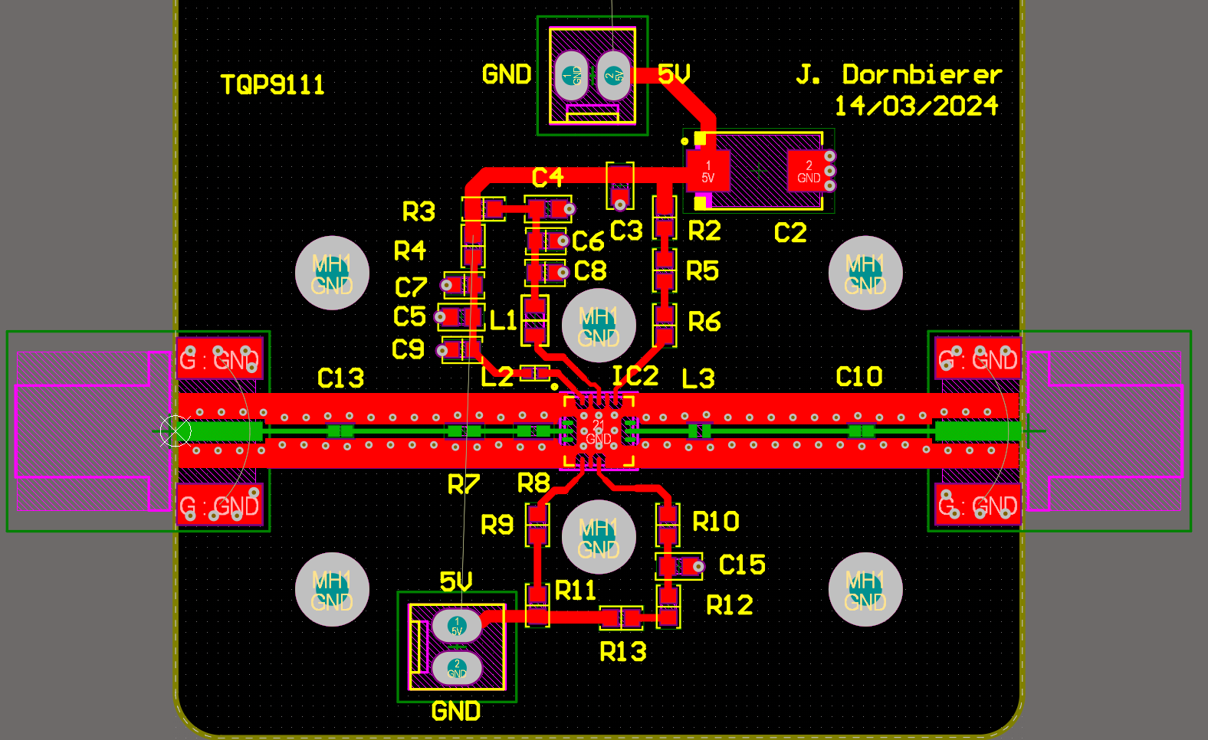
Theory PA Thesis/Funkamateur Besprechungen/PA_ARMIN_ACHIM/PCB_Layout.png
