JohnPD99/PA_stage_Cubesat/Theory PA Thesis/Funkamateur Besprechungen/PA_ARMIN_ACHIM/Qucs_Development_Board_Qorvo.png

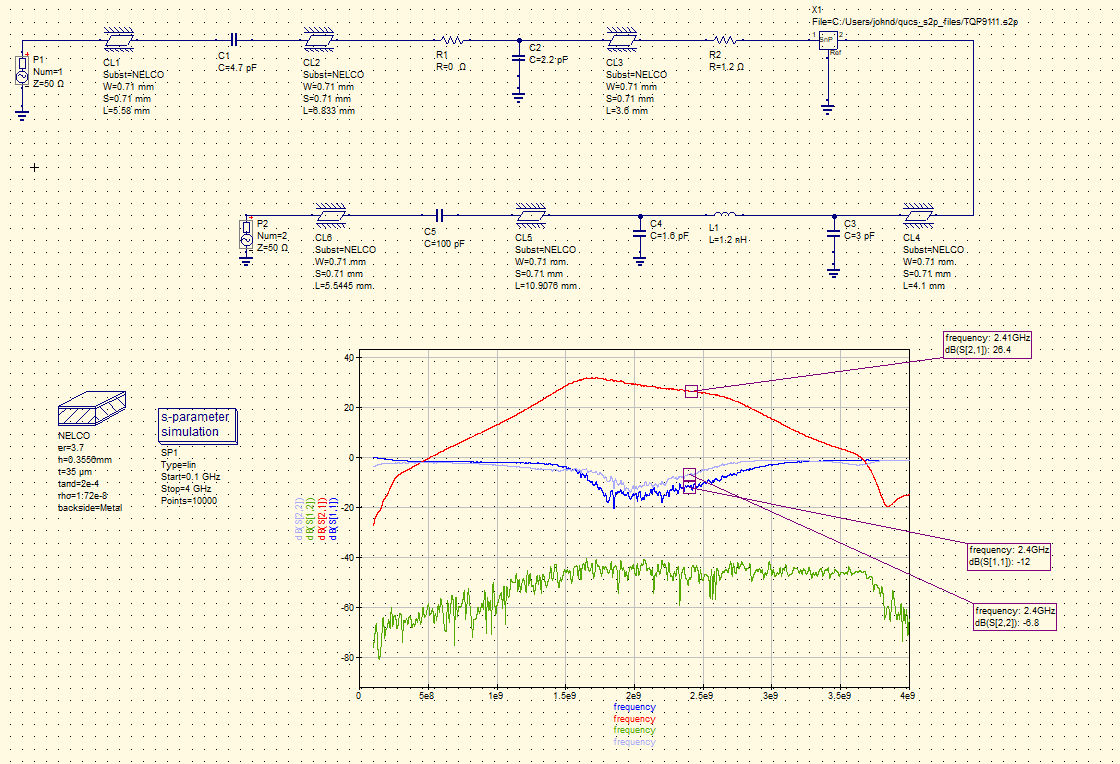
Theory PA Thesis/Funkamateur Besprechungen/PA_ARMIN_ACHIM/Qucs_Development_Board_Qorvo.png
