JohnPD99/PA_stage_Cubesat/Theory PA Thesis/Funkamateur Besprechungen/PA_ARMIN_ACHIM/Qucs_Linear_Transponder_prototype_v2.png

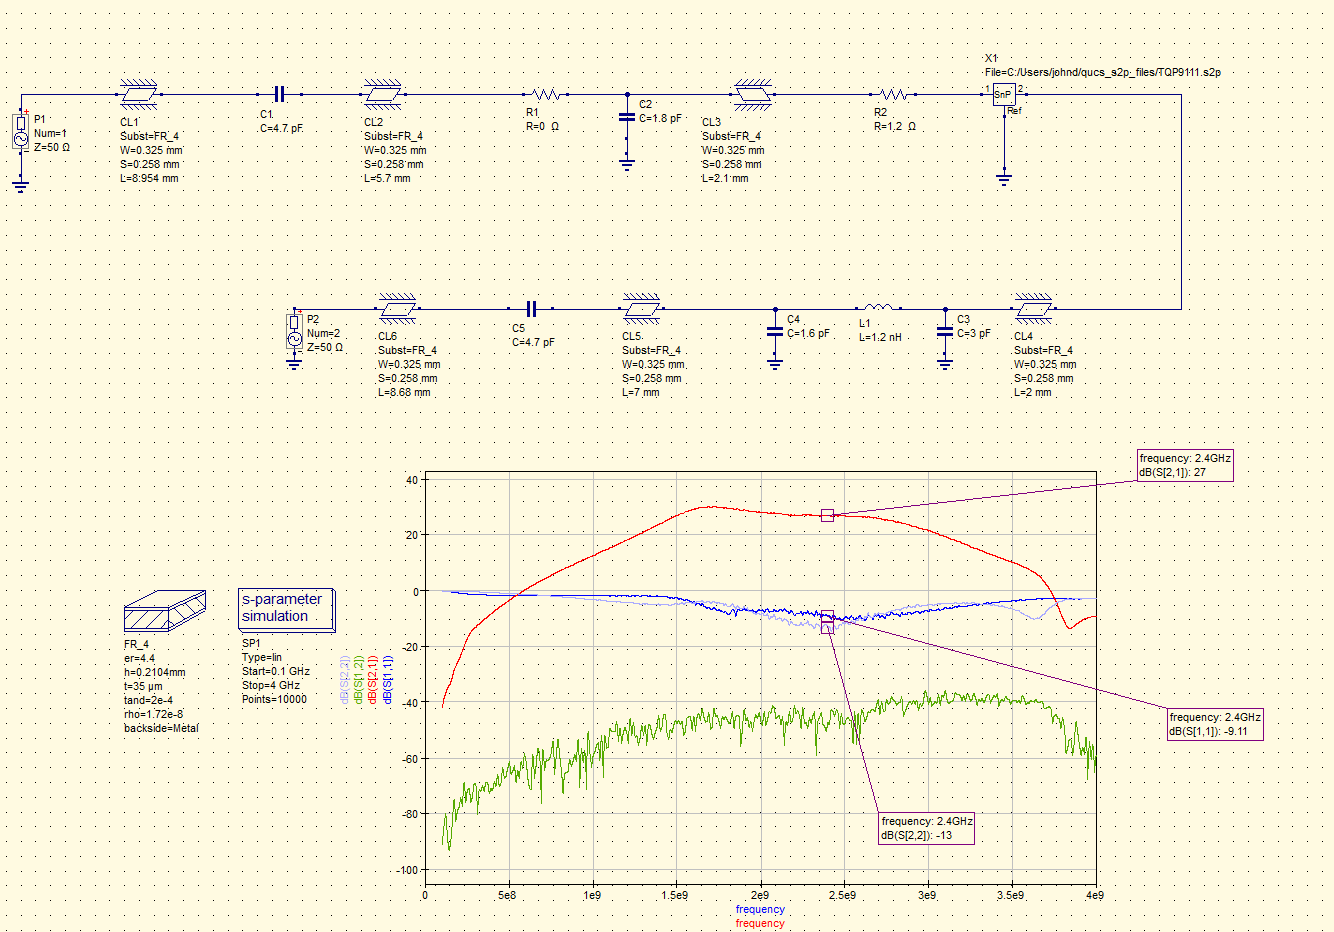
Theory PA Thesis/Funkamateur Besprechungen/PA_ARMIN_ACHIM/Qucs_Linear_Transponder_prototype_v2.png
