JohnPD99/PA_stage_Cubesat/Theory PA Thesis/Funkamateur Besprechungen/PA_ARMIN_ACHIM_Improved_Matching/Optimised Matching_FR4_Prototype_v2.png

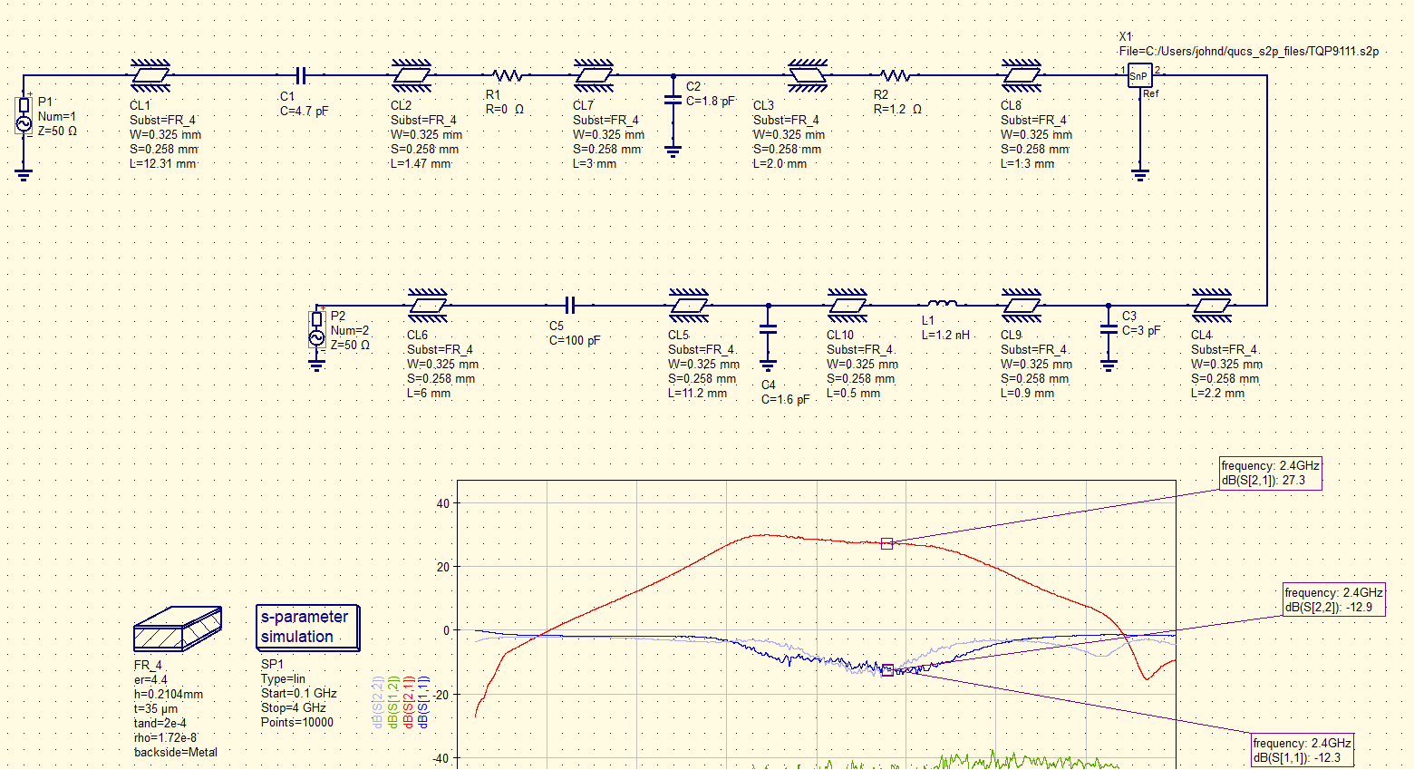
Theory PA Thesis/Funkamateur Besprechungen/PA_ARMIN_ACHIM_Improved_Matching/Optimised Matching_FR4_Prototype_v2.png
