JohnPD99/PA_stage_Cubesat/Theory PA Thesis/Funkamateur Besprechungen/PA_ARMIN_ACHIM_Improved_Matching/Optimised Matching_NELCO.png

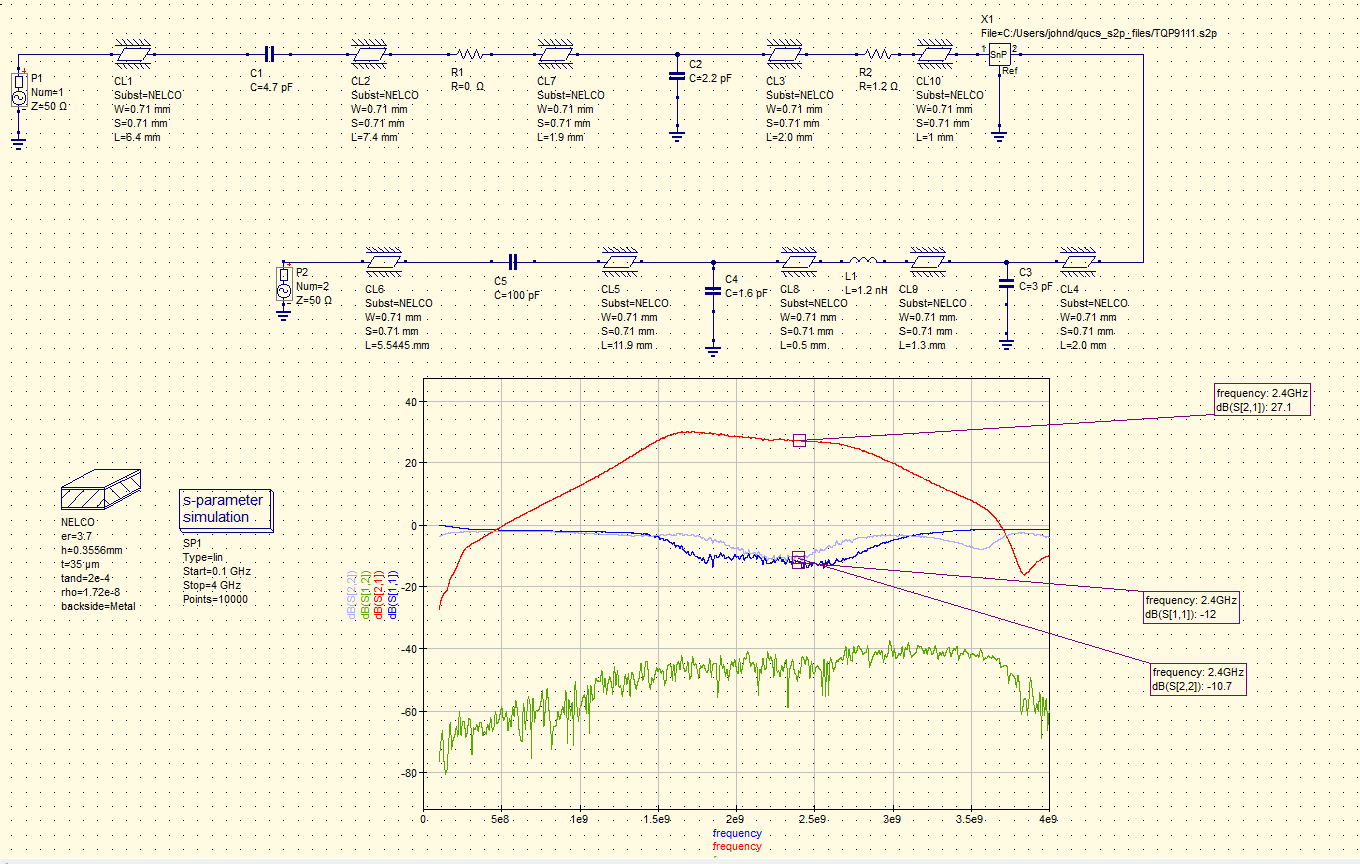
Theory PA Thesis/Funkamateur Besprechungen/PA_ARMIN_ACHIM_Improved_Matching/Optimised Matching_NELCO.png
