JohnPD99/PA_stage_Cubesat/Theory PA Thesis/Preliminary Prototype (fail)/AMPAY_thermals.jpg

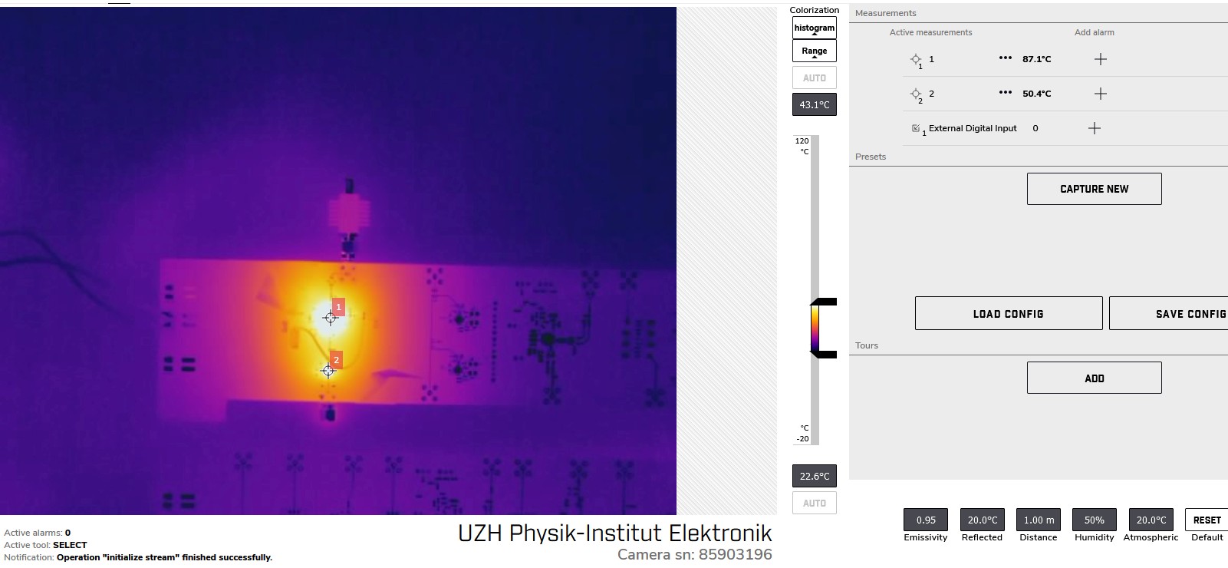
Theory PA Thesis/Preliminary Prototype (fail)/AMPAY_thermals.jpg
