JohnPD99/PA_stage_Cubesat/Theory PA Thesis/Preliminary Prototype (fail)/WhatsApp Image 2024-03-07 at 18.50.09_4712afcf.jpg

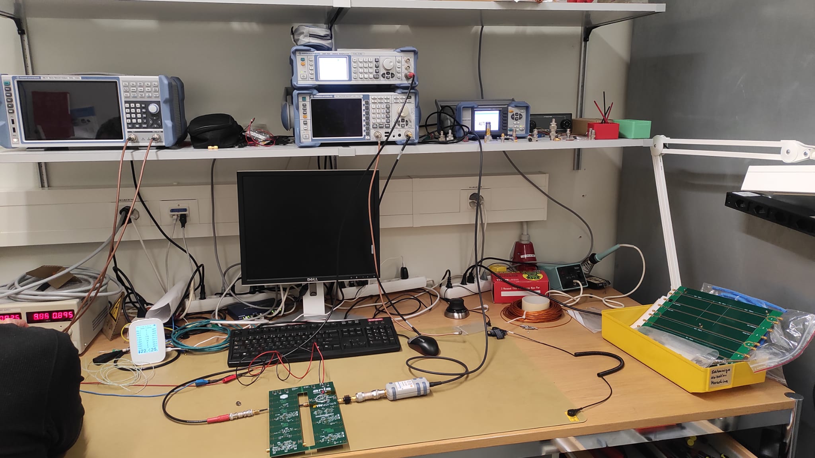
Theory PA Thesis/Preliminary Prototype (fail)/WhatsApp Image 2024-03-07 at 18.50.09_4712afcf.jpg
