JohnPD99/PA_stage_Cubesat/Theory PA Thesis/Devboard_TQP9111_Qorvo/Devboard_Qorvo_measurements.png

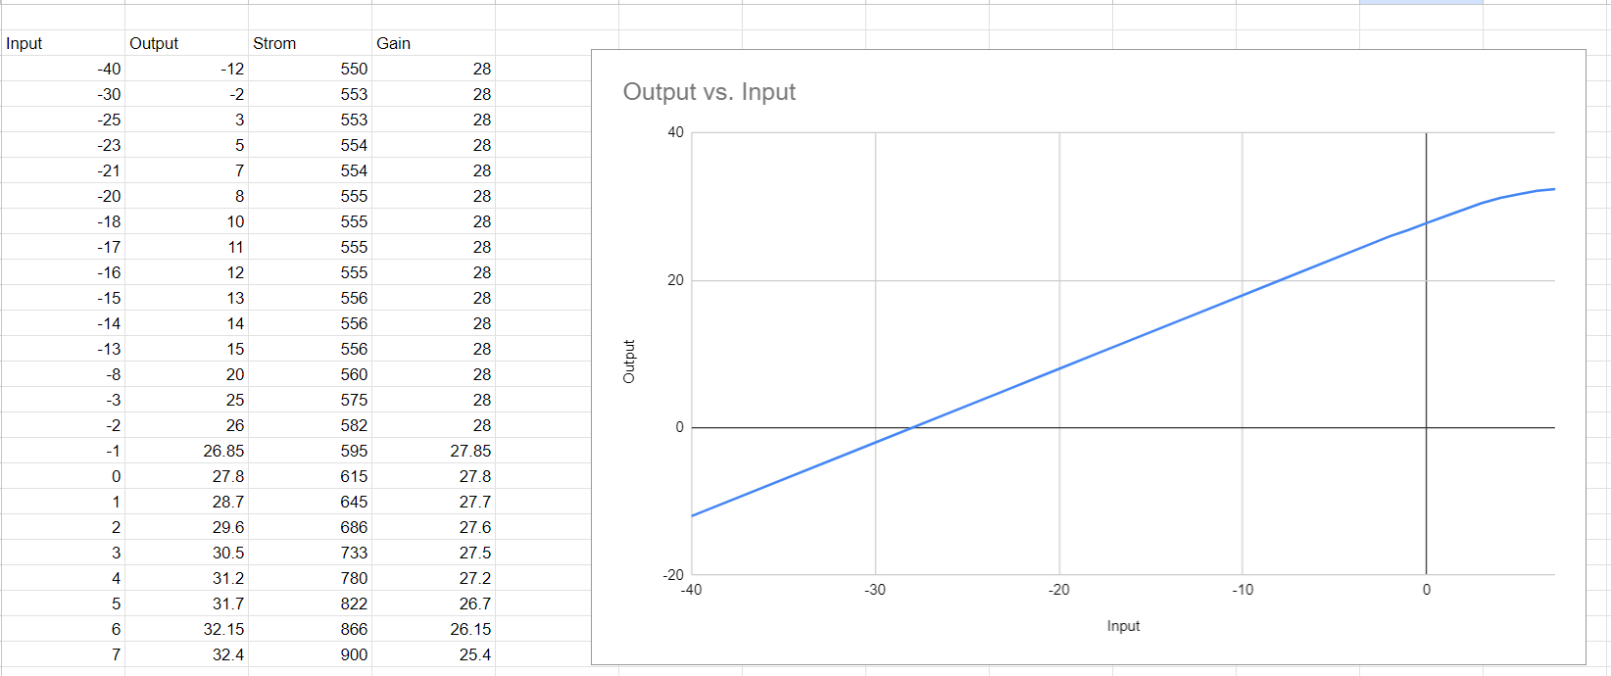
Theory PA Thesis/Devboard_TQP9111_Qorvo/Devboard_Qorvo_measurements.png
