JohnPD99/PA_stage_Cubesat/Theory PA Thesis/Preliminary Prototype (fail)/Power Amp measurements.pdf

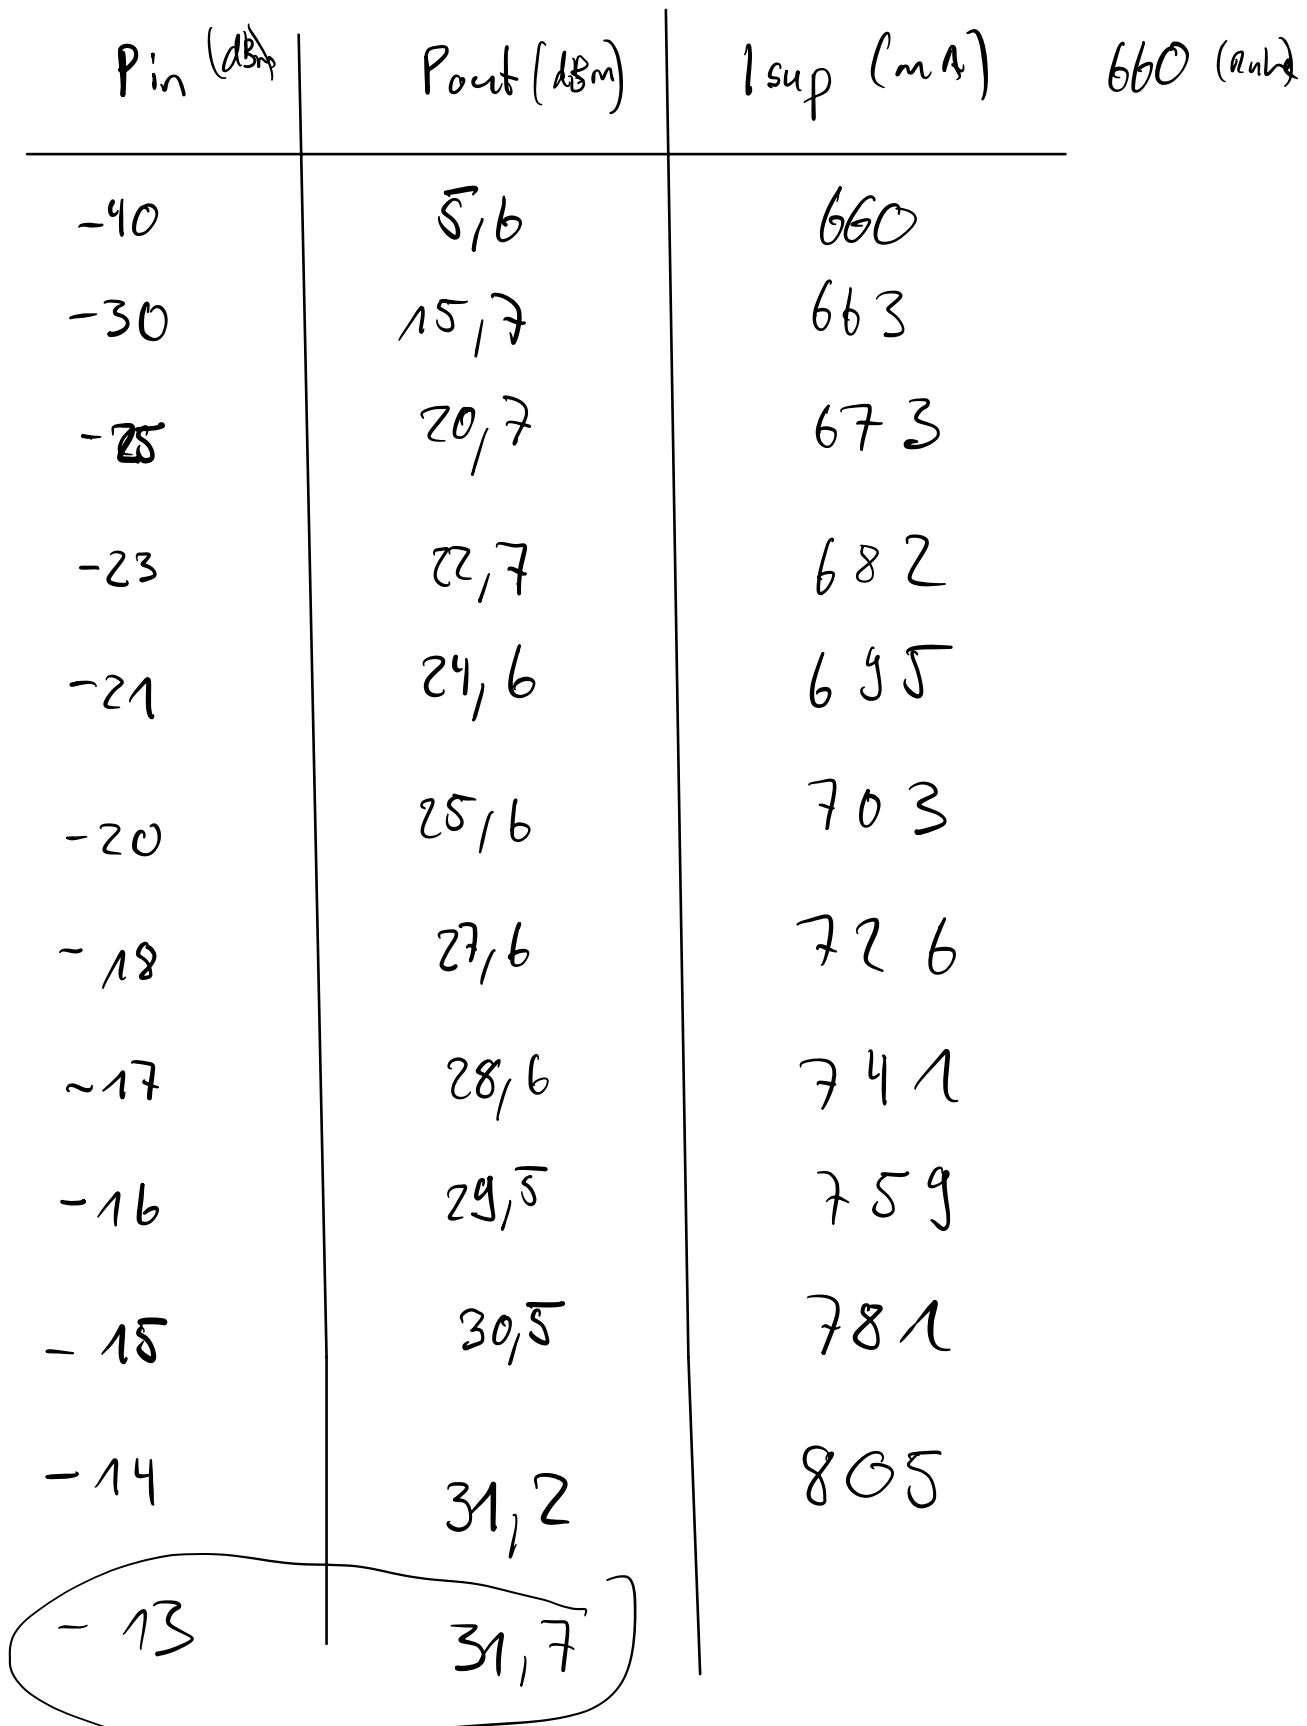
[picture p49: page 1]

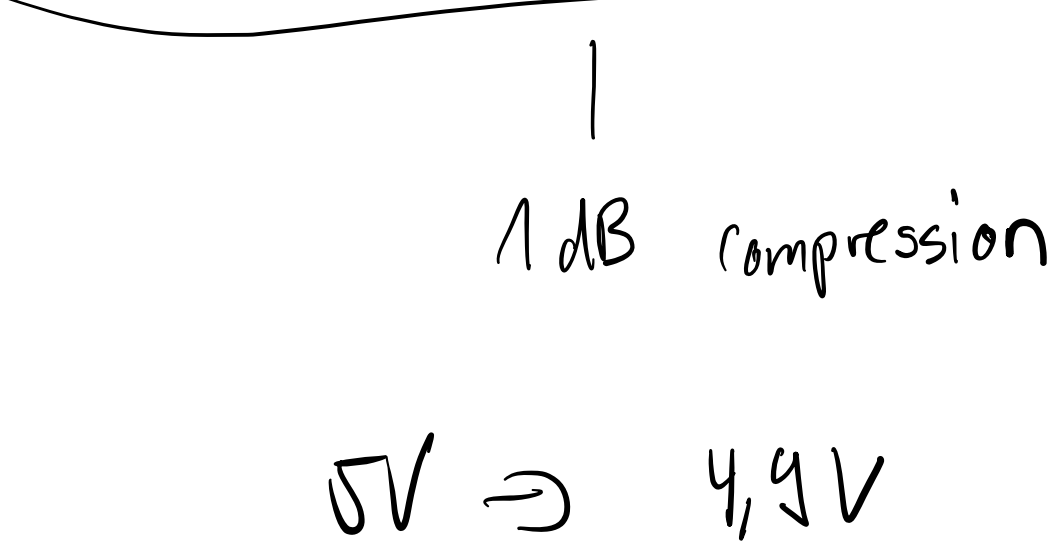
[picture p50: page 2]
