JohnPD99/PA_stage_Cubesat/Theory PA Thesis/Funkamateur Besprechungen/PA_ARMIN_ACHIM/PA Wärmeabfuhr.pdf

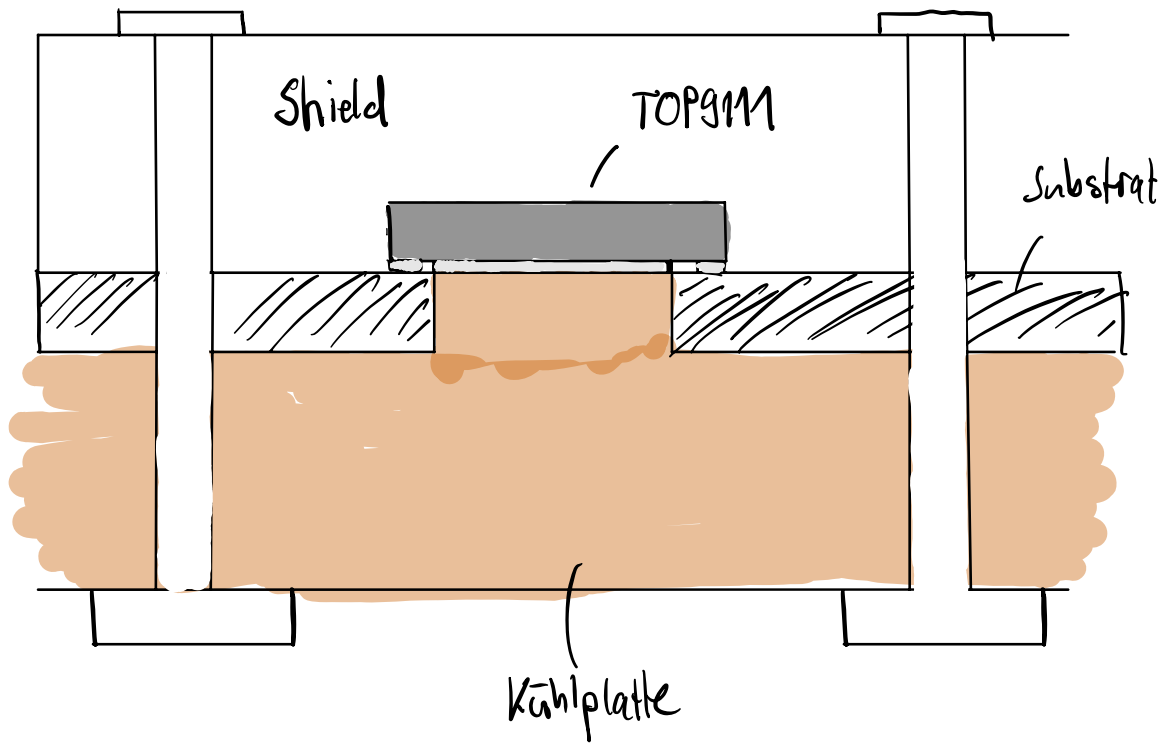
[picture p51: page 1]
