JohnPD99/PA_stage_Cubesat/PCB1.pdf

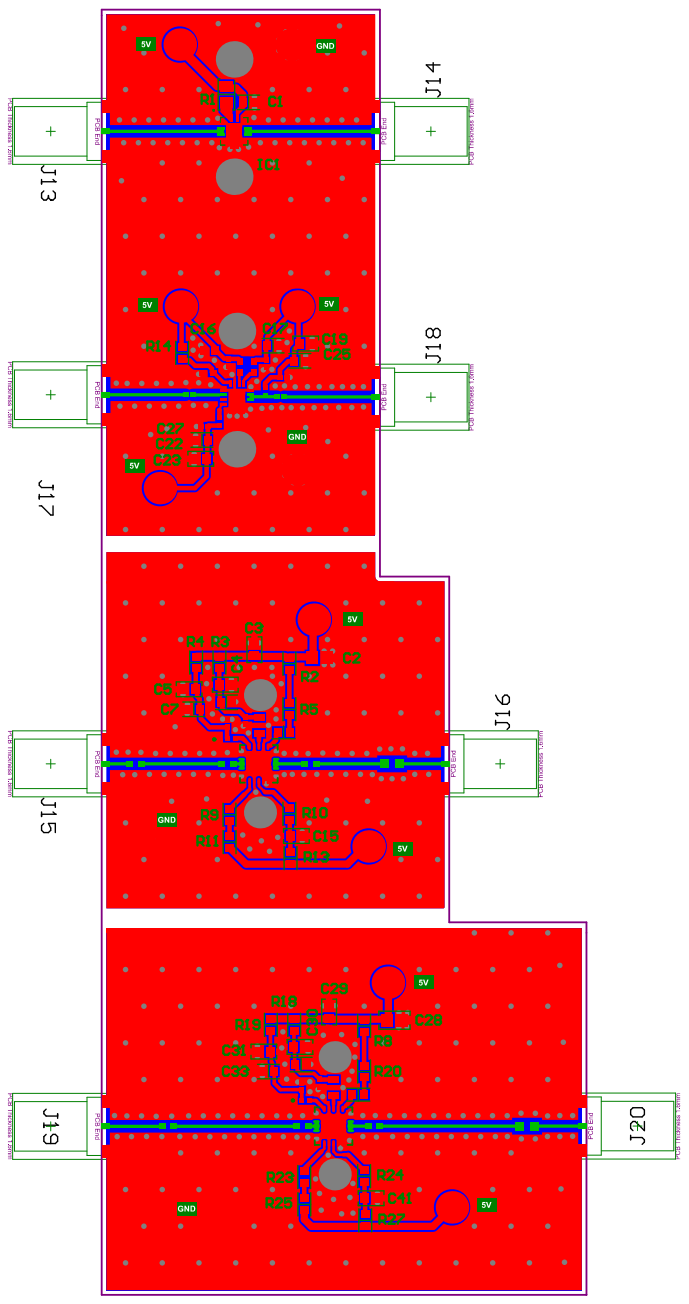
[picture p52: page 1]
