JohnPD99/PA_stage_Cubesat/(list of files, drawings)

Other design files:
MNA6A.SchDoc
PA_stage_Thesis.PrjPcb
PCB1.PcbDoc
QPA9120.SchDoc
TQP9111_Devboard_opt.SchDoc
TQP9111_Sparam_opt.SchDoc
