JohnPD99/PA_stage_Cubesat/(commit log)

2024-03-13 Started project
    [Mainamp_schematic.SchDoc, PA_stage_Thesis.PrjPcb, Preamp_schematic.SchDoc]
2024-03-13 Schematic complete
    [Mainamp_schematic.SchDoc, PA_stage_Thesis.PrjPcb, PCB1.PcbDoc, Preamp_schematic.SchDoc]
2024-03-14 schematic nearly complete
    [Mainamp_schematic.SchDoc, PCB1.PcbDoc, Preamp_schematic.SchDoc]
2024-03-14 small changes
    [PA_stage_Thesis.PrjPcb]
2024-03-14 placement finished, now only routing left
    [PCB1.PcbDoc]
2024-03-14 Finished Prototype Eval Board v1.0
    [Mainamp_schematic.SchDoc, PCB1.PcbDoc, Preamp_schematic.SchDoc]
2024-03-16 Ready for final review
    [Mainamp_schematic.SchDoc, PCB1.PcbDoc, Preamp_schematic.SchDoc]
2024-03-28 Design near complete
    [Mainamp_schematic.SchDoc, PCB1.PcbDoc, Preamp_schematic.SchDoc]
2024-03-29 added second preamplifier for testing purposes
    [Mainamp_schematic.SchDoc, PA_stage_Thesis.PrjPcb, PCB1.PcbDoc, Preamp1_schematic.SchDoc, Preamp2_schematic.SchDoc]
2024-03-29 nearly complete
    [Mainamp_schematic.SchDoc, PA_stage_Thesis.PrjPcb, PCB1.PcbDoc, Preamp1_schematic.SchDoc, Preamp2_schematic.SchDoc]
2024-03-29 Complete
    Check if correct capacitors are used
    [Mainamp_schematic.SchDoc, PCB1.PcbDoc, Preamp2_schematic.SchDoc]
2024-03-30 Design complete
    Change distance betwen 50 ohm trace and gnd pour
    [PA_stage_Thesis.PrjPcb, PCB1.PcbDoc, Preamp2_schematic.SchDoc]
2024-04-02 small updates
    [PA_stage_Thesis.PrjPcb, PCB1.PcbDoc]
2024-04-02 added simulations for matching circuit
    [Complete_Match_FR4_optimised.sch, Complete_Match_datasheet.sch, Complete_Match_datasheet_optimised.sch, Complete_Match_devboard_qorvo.sch, Load_matching_FR4_optimised.sch, Load_matching_datasheet.sch, Load_matching_datasheet_optimised.sch, Load_matching_devboard_qorvo.sch]
2024-04-29 Added all of the theory stuff
    [Complete_Match_FR4_optimised.sch, Complete_Match_datasheet.sch, Complete_Match_datasheet_optimised.sch, Complete_Match_devboard_qorvo.sch, Load_matching_FR4_optimised.sch, Load_matching_datasheet.sch, Load_matching_datasheet_optimised.sch, Load_matching_devboard_qorvo.sch]
2024-04-29 file restructured
    [Complete_Match_FR4_optimised.sch, Complete_Match_datasheet.sch, Complete_Match_datasheet_optimised.sch, Complete_Match_devboard_qorvo.sch, Load_matching_FR4_optimised.sch, Load_matching_datasheet.sch, Load_matching_datasheet_optimised.sch, Load_matching_devboard_qorvo.sch]
2024-05-19 Finished Schmatic
    Now do layout: setup rules, setup layer stack manager, do placement (impedance matching) and routing
    [MNA6A.SchDoc, PA_stage_Thesis.PrjPcb, PCB1.PcbDoc, QPA9120.SchDoc, TQP9111_Devboard_opt.SchDoc, TQP9111_Sparam_opt.SchDoc]
2024-05-19 layout finished
    Now routing
    [PCB1.PcbDoc, TQP9111_Devboard_opt.SchDoc, TQP9111_Sparam_opt.SchDoc]
2024-05-19 started routing
    [MNA6A.SchDoc, PCB1.PcbDoc]
2024-05-19 layout 80% complete
    [MNA6A.SchDoc, PCB1.PcbDoc, QPA9120.SchDoc, TQP9111_Devboard_opt.SchDoc, TQP9111_Sparam_opt.SchDoc]
2024-05-20 layout nearly complete
    [PCB1.PcbDoc]
2024-05-20 DRC check now
    [PCB1.PcbDoc]
